RoboticsHardwareSolutions/BareMetal-PLCs-Vault/docs/baremetal-plc-m/doc/drawing/status-report.txt

Project Outputs Generation Report
---------------------------------
Start Output Generation At 17:46:57 On 29.01.2026

Output: Export STEP
Type  : ExportSTEP
From  : Variant [[No Variations]] of PCB Document [pcb.pcbdoc]
   Generated File[pcb.step]

Files Generated   : 1
Documents Printed : 0

Finished Output Generation At 17:47:27 On 29.01.2026
