RoboticsHardwareSolutions/BareMetal-PLCs-Vault/docs/baremetal-plc-m/doc/pcb/status-report.txt

Project Outputs Generation Report
---------------------------------
Start Output Generation At 17:47:40 On 29.01.2026

Output: Bill of Materials
Type  : BOM
From  : Variant [[No Variations]] of Project [bmplc.prjpcb]
   Generated File[Bill of Materials-bmplc.csv]

Files Generated   : 1
Documents Printed : 0

Finished Output Generation At 17:47:41 On 29.01.2026
