RoboticsHardwareSolutions/BareMetal-PLCs-Vault/docs/baremetal-plc-m/doc/photo/status-report.txt

Output: bot
Type  : PCB 3D Print
From  : Variant [[No Variations]] of PCB Document [pcb.pcbdoc]
   Generated File[bot.png]

Files Generated   : 1
Documents Printed : 0

Finished Output Generation At 17:46:51 On 29.01.2026
