RoboticsHardwareSolutions/BareMetal-PLCs-Vault/docs/baremetal-plc-m/doc/pcb/gerber/status-report.txt

Output: 4 layers NC Drill Files
Type  : NC Drill
From  : PCB Document [pcb.pcbdoc]
   Generated File[pcb-RoundHoles.TXT]
   Generated File[pcb-SlotHoles.TXT]
   Generated File[pcb.LDP]
   Generated File[pcb.DRR]

Files Generated   : 4
Documents Printed : 0

Finished Output Generation At 17:46:44 On 29.01.2026
