RoboticsHardwareSolutions/BareMetal-PLCs-Vault/BareMetal PLC M.md

![[BareMetal PLC L 2024-09-29 01.40.09.excalidraw|800]]
```table-of-contents
```

## BareMetal PLC M Description

### Overview

BareMetal PLC M Controller has various powerful features and can service a wide range of applications. The controller has the following interfaces on board:  CAN bus, RS485, RS422, RS232, 5 relay outputs, 5 discrete inputs, 5 discrete outputs, USB Device, EEPROM.  The main microcontroller is built on the Cortex-M3 core with a clock frequency of 72 MHz. 
### Hardware description

- Onboard [Rlink](https://github.com/RoboticsHardwareSolutions/rlink) programmer 
- MCU Cortex-M3: 72 MHz 
- RAM: 64 Kbytes 
- FLASH: 512 Kbytes 
- 256K  EEPROM
- 5 Relay outputs 55V  1.5A ( Max switch frequency 3Hz )
- 5 Discret Outputs (12-24V 70mA)
- 5 Discret Inputs  
- CAN Bus 
- RS485 
- RS232
- RS422
- USB Device

### Functional Diagram

![[BareMetal PLC L 2024-10-01 22.33.12.excalidraw|800]]
### Pinout and symbols 

![[BareMetal-PLC-M/doc/pinout/pinout.png]]

### Dimensions
![[Screenshot 2025-08-05 at 22.21.13.png]]

![[Screenshot 2025-08-05 at 22.21.29.png]]
![[Screenshot 2025-08-05 at 22.21.38.png]]

 3D model in .stp [here](https://github.com/RoboticsHardwareSolutions/BareMetal-PLC-L-assembly/blob/main/doc/assembly.stp)
