RoboticsHardwareSolutions/BareMetal-PLCs-Vault/attach/BareMetal PLC XL Product Brief 2024-09-28 23.10.22.excalidraw.md

---

excalidraw-plugin: parsed
tags: [excalidraw]

---
==⚠  Switch to EXCALIDRAW VIEW in the MORE OPTIONS menu of this document. ⚠== You can decompress Drawing data with the command palette: 'Decompress current Excalidraw file'. For more info check in plugin settings under 'Saving'

# Excalidraw Data

## Text Elements
## Embedded Files
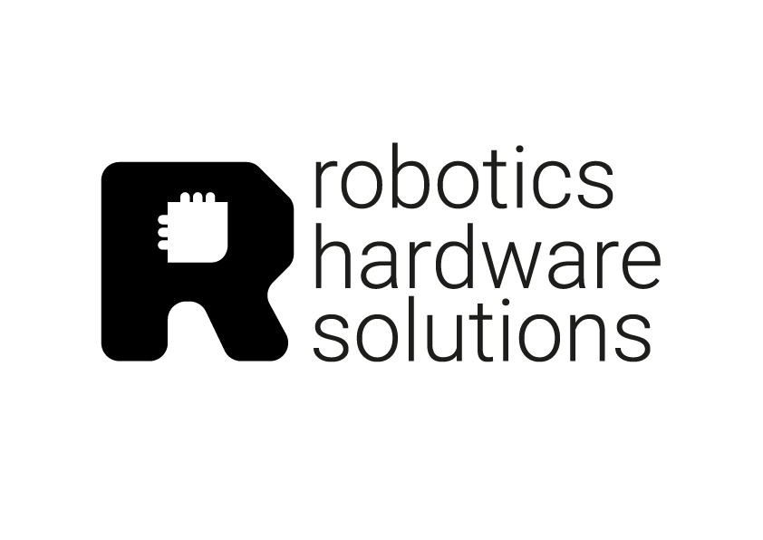
[picture p3: attach/Ресурс 1.png]
17b8354cb87843ab43a2fff041e272dd4be9363e: 

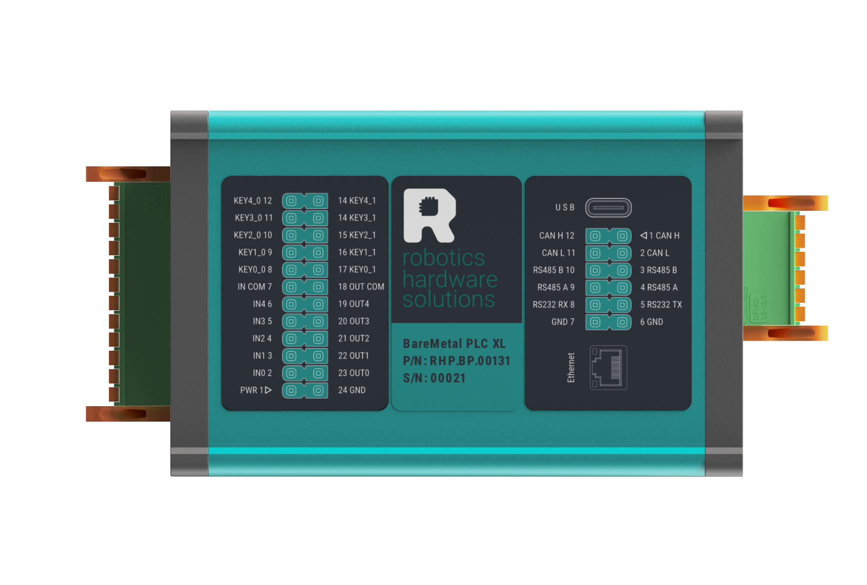
[picture p4: attach/roboticsALPHA.5b_site.png]
7c678ffba9f373350790c60da8705a2cec17a8e8: 

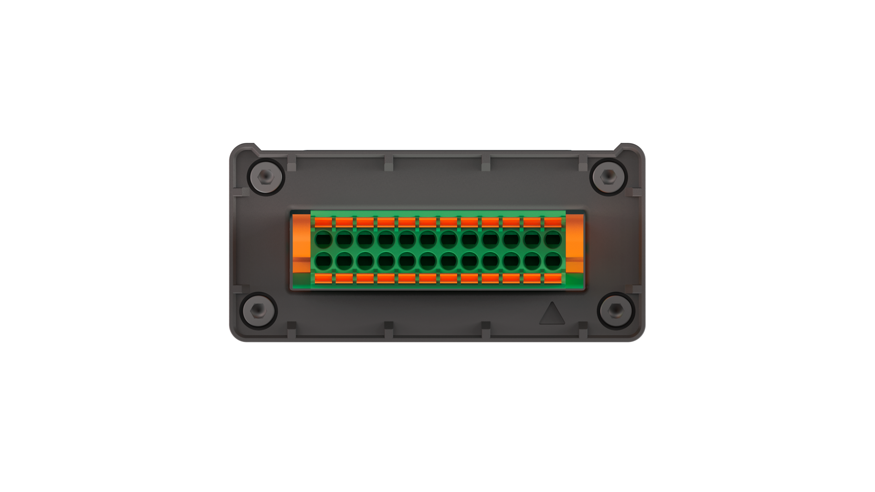
[picture p5: attach/roboticsALPHA.2a.png]
c31809eb0690865eb3441511a125cf84ea4b2b4b: 

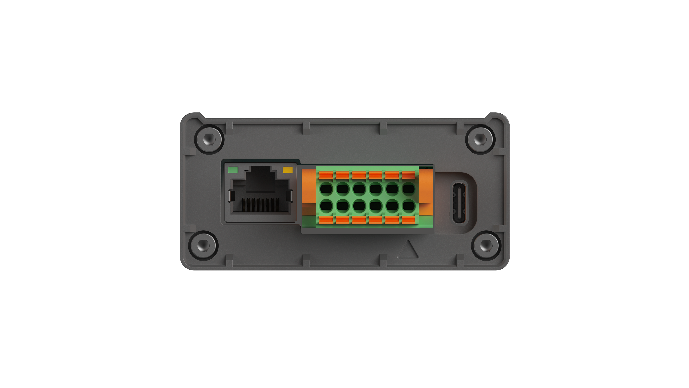
[picture p6: attach/roboticsALPHA.1a.png]
b8611a6e1363eb58c7db57ecf36b8be5c3dcc07f: 

%%
## Drawing
```compressed-json
N4KAkARALgngDgUwgLgAQQQDwMYEMA2AlgCYBOuA7hADTgQBuCpAzoQPYB2KqATLZMzYBXUtiRoIACyhQ4zZAHoFAc0JRJQgEYA6bGwC2CgF7N6hbEcK4OCtptbErHALRY8RMpWdx8Q1TdIEfARcZgRmBShcZQUebQAObQBmGjoghH0EDihmbgBtcDBQMBLoeHF0Qn1opH5SxhZ2LjQAFgB2AAY6yAbWTgA5TjFuAEYOgE4eePi2kZGk7ohCDmIs

bghcFMXCZgARdKgEYm4AMwIw7eOJfQB5ABkANgBlDk19VJLIE8J8fCfYYLrSS4bAaQIfUrMKCkNgAawQAHUSOpRosoTD4f8YICJIIPBDIDC/JIOOFcmgRos2HAQWoYKMOl1CpBrMocagmZ8IJhuM4kklEi14h0AKxJHjjJIdHhJFotB6LeloPnjFraB4jNqSyZJcbjB76tHQuEIADCbHwbFI62h1mYNMC2QJEE0INhyiJK3NlutEltHHtuEdUGdF

GRkm4IsZi0kCEIymk3CSYu04xGOr1HRa42mlOZEDCR0j8QF8UWHuEcAAksRyag8gBdRYnciZGvcDhCX6LT3EUnMOud7v5zTCFYAUWCmWydcbiyEcGIuEOV1Qmp4bRFW4eG+T40WRA4sI7XfwB7Y2Hhq7O+Au+ahy6EdYgiBWy2Uzu+wXbEk1mhLIotNg/5tPELRJLgmjgbgPAnHBWYjAgG48MQxAtJoCCSg8SS1Pe7gVAUnxgHmREjMyTb5tgMJw

CevyFAAvnUxSlCQ6wAJoAIodAA4gA0gAEgAskYzqwIg6xVDUzo8sqsoPNoIpjKBBoSvqIplvmSqoM48zyZqO48GKSRtBKcwKvmYbECirR6qmer2Q59ktDGcYJiGaD8m02g8Aa6kioZsoihqbSLKy7KcpCxrwt6Vo2uQAYOlkIaLK6l4VkIXoWrFfrxYGwafj8fwAhUUggmCuFcuiJpIlZEYUkaGIIFi7IFharE9sICb9nWJGlNStKwAyEWEmOfZk

rRZ73ggRZoAZ8S9T0TB9M0a6SosvRNIMHDDGgPBZkkGqqlq86LsuM1rpuco8CMYE8C06bbHsBznTed5cul1a1vkFFcqOGXEJOGRJbOP2lIex5oEOk1cpal4vecCDNj8CA/ugbTYA8oFwa64wnMZ/JRlqHQYx0S4zKKMFiNgmq4PECDxM6zD4fkzLEd0xHkdsKxrBIuAtBADFMfmrESPEmCwicGpPEIonlBJ1TKBVpQydpUqJFu/njEFe3CvK5lcl

pe1eWmGtSiMGotFmIqLJZ1moHK4wJAhcqgZbhr5rG8aJrtKbzOmmOSp0JsLPmYUVMNBZRWaWW+ug/p5Ulzqpe6vYxbH0C5YlTpI78zUlcCoIiErAhRzVdsLZHjV5+seLtfmRJdeN9X5v12B0kNHX/d1E1otNq5TJ0IX5htnBJiZ61LZtQwVCZUwPC0W4nUuK6jJdLTXZM2HTI9+zBCvaCvYj+YfTWIMpaNgPTjk30HssEOoFD55w9eCM5yjq4QNg

SQ3RMCCaB0BoOjxAeCKP+sp7qKRGLgEYhlsAnDAiEdCPAoKaEZszNAhFPgLQ5p8UGkBlirBVhsEUAsSiMUKMxfBH9YTcQAI4cRgD8ekiwxIlUkoraSvI1beRUpMGU/lFIaQNtwSU2gOjpnaLMeeup55CNKLbOq9s5QKV3OvGUcoJhBRcl7dyvAozaHNjKHUyZtY+VChwNk4cGomjTnFO0WdkojjdOlTKPo7EJSDInHORVsT5zKkXRmpdwyonvFHa

uuI2rHE7o3AcISuSt3bhSaM9dRrd0hqeXu50SzYRDlyEeK0Rhigno0AY08RHr3GFmKYFcFzL3OpqQC690w8BabKHez0X63iPu9Ikn0z4jgvlOYGN98zgx7qMi8V5Tiv3zF+d+6x/waigQ8BAukcKaHUtgNoxANltAQHAg6/4MIii/sQbA2AOhtBOGgggBFWbYLIrgrmhD1i4AeKQsA9FwA/Q2HAOA/wzrcGYtAWMmR1hEDchCBghAEAUAAELONTj

HdYABiOC6Lrl1E/iIYMVZDj6H+I1WxEgUWITJUrbFpBcX4oRWlJFbicr2M8dnQolLqUZAAGKFXCegWuUTWXYBxUlPFGRCXVWCbtLFgqqXCvxWKzExUa6RKhdK9l+gABKnUSRNzXFKoV2QRW3BpG3QaSSIpstlZyzgUAOW4H0EwyMeqZUGvxRy61TxCBGAqHtJ1aqAAqWAoAAEEIUrQgMEE4jjSiqstQSqIpBg1UrYBQWMuBVyPwFfqqAhrxwrCDU

mlNIQP5BhhFQX1sb82lr9XLCQvYoVMxhL8AAGiInM6opjTGMpjEy80sUNotPgNi3BwIjFTEFEyDxxHdpgViowbADBAuHgQIQFRR3XQePPcYgtM3OuzfizVXcdUQDrVij0JAPVeu4D61lZ7iD/AQDRNA1sb2kBIIJNgqxc2QWCJ0t6kBb3EtQJQiAcKLQf1IMoV0AAKa6IVeCamoPBuDHQFIAEpnTqoQMoLsQZ1gQegzKLovApSIcI4hlDIp0Pbuj

Vm+VCAbhwCgE0QcGTWUtjtQgTD3NX0WMXVyLI37zrQhXYsbARBH2oGE900oHAOPcCk1SIQUBDwVCk9RyAdgABW+ycgvFwHAd9n7ZOaB/dMrpWKQRMcYH6+d+A+OlFYTXdI2AmOj1E0+KABhq3iXScOGGkz4bmdGaEYNLnCDWdsxNBi4ByFfGRnWYAXz6JAA=
```
%%
