RoboticsHardwareSolutions/BareMetal-PLCs-Vault/attach/BareMetal PLC L 2024-09-29 01.40.09.excalidraw.md

---

excalidraw-plugin: parsed
tags: [excalidraw]

---
==⚠  Switch to EXCALIDRAW VIEW in the MORE OPTIONS menu of this document. ⚠== You can decompress Drawing data with the command palette: 'Decompress current Excalidraw file'. For more info check in plugin settings under 'Saving'

# Excalidraw Data
## Text Elements
## Embedded Files
17b8354cb87843ab43a2fff041e272dd4be9363e: 

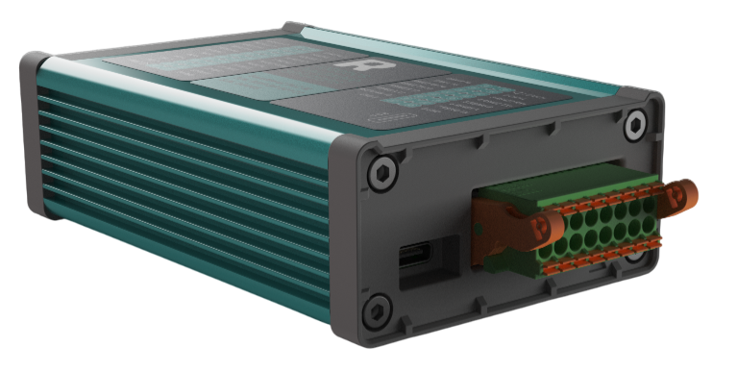
[picture p7: attach/Untitled3.png]
45a09c3cb31096cdb58ccd8873f9a5ce9564a077: 

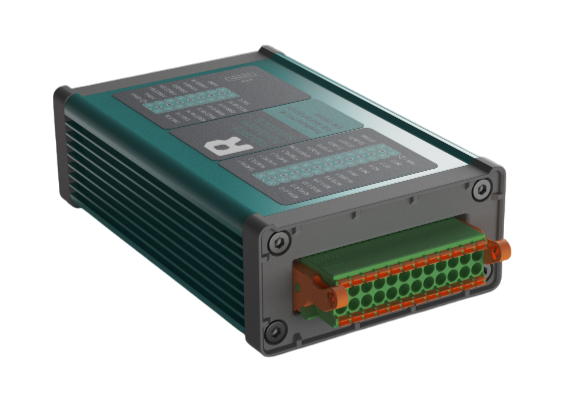
[picture p8: attach/Untitled.png]
ec1cabf1424fadb6adf64a130d58d2e07b59a7e2: 

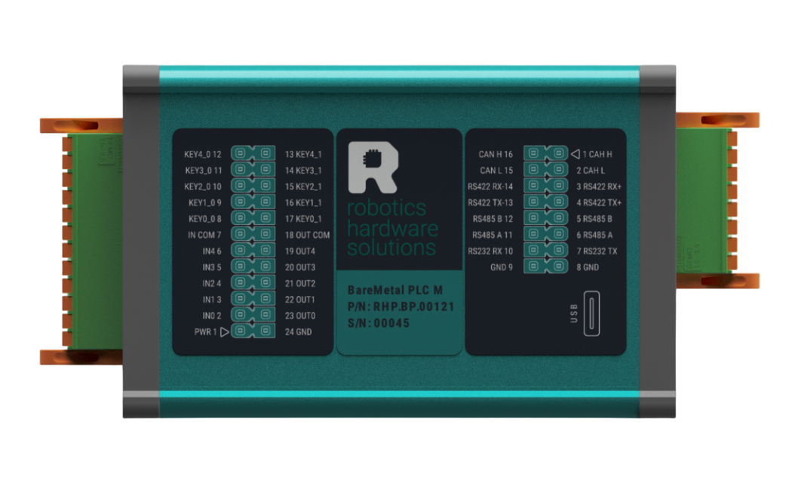
[picture p9: attach/Untitled 2.png]
acdc02df39efdd17fbaf7d9cfea49035cd332f42: 

%%
## Drawing
```compressed-json
N4KAkARALgngDgUwgLgAQQQDwMYEMA2AlgCYBOuA7hADTgQBuCpAzoQPYB2KqATLZMzYBXUtiRoIACyhQ4zZAHoFAc0JRJQgEYA6bGwC2CgF7N6hbEcK4OCtptbErHALRY8RMpWdx8Q1TdIEfARcZgRmBShcZQUebQBWbQBGGjoghH0EDihmbgBtcDBQMBLoeHF0Qn1opH5SxhZ2LjQAdgAWAGY6yAbWTgA5TjFuHiSkgA4W+KT4tpbuiEIOYixu

CFwO1JLIQmYAEXSoBGJuADMCMIWSNf0ASQBpbABZABU4ACsAGWIAKQAlNowABqbCMAC0AIJtfpbUqnQj4fAAZVgwTWklw2A0gVhAigpDYAGsEAB1EjqbhJBbMfFEhAomBoiSCDy4iAEvySDjhXJoKmFSBsOCYtQwSkABnFC2syiZqClAogmG4ziS4sS8Q6ADYAJxJLUdeLjHhtHjGhZitDOA1JbSGrUtPXjLU8DpjNrU2nEgDCbHwbFIa3x1mYws

C2TZmkxhOUHOWvv9gYkwY4odw4agbIo5Mk3HiLS12i1+fzOo6krmboWkgQhGU0m4bXF42S43Fps64p4Orm80VYWOlJ4PBd0zaxYWseEcFuxF5qDyAF0FqdyJlZ9wOEJEQs48Rucx51ud4rNMJlgBRYKZbLzpcLIRwYi4I4nPktQ3ix08L+THULIgOEJTdt3wAC2GwYk31Qc58EufsoigIR5wgRBliWZQ2XhYINwkJIWk0cZDTabBCJacZOlwTRKJ

4U46PbJIEB4FoeGIYg2k0BAywNWp+3cCoCm2MB+SEpIBUXQoAF86mKUpYEQNYqhqNleiaPN4niBZVIGIYKh4DSiLbTormWVYJFweI2V2A5glfM4LgQK5oIgT4jCBAAJAAhbAOgAcSwhFkVRCopExbFeO2CAaQJYkyWICk+U9GL6WCtYWWuXdhHrA95xE0ohRFWAJQVSKZTlErSmVK1OhaIt4h1eJR3q8sdT7SLLVQDouqLNo9XFd19I/NrSmiukE

wDINyFTMMskzBYo0gqchHjP0JuTKa0wzLMc24VrC1dHViyScdWsarpFRrOsGzQXrbXLCYOhNUZZi1PKBAQQc0DbdotUnDkZznfJl0VVdcHXaDjzAxU9xykCT0is9luIK8Mlmu9gcix9nzs99P3I/CmySf9FUA4C0Eh8DIM+mCHM9F9kLWNDHA4TCVwRBBcPQNp4lwcUdR80i3T5rVsGITQjWwUXxkmDpTh1CyxAarU2l5loWjZZh+PyAVhO6YTxK

kmTFXkkKlOUCL6iYPpmlQNU+EVbSOEGDhhhu4cvzGfMTJWKr0AsoErP2Q5qdg+DIuuZMIRJeIEF8mAAEcAsRBk5VCrERAtvFkrihLbaSukU5C9KTkyzlYcSxUCuwUViulFnyoWX3nG5jptB1cYxhmYd9I7zTFQ65wOjaW0yzaDuZg0gs1fzn1VqTdAU022bI2jJaVsTSaQxmiMFmzeLcz5d1tHGeqx5afrlZLata3rTM0C1cYdTqljlfFV6h6H6k

Puglo1QdP7pyznRiuNcHMIagVLsscuqAKannPMja8aMgYPifC+am+E8YdxYvqX6JMlhkxgRAkmEEoL2Tgo5BC9MUJMwwknMBaxMTEGwF2YgpwOg6gQKcNi+FThRlOC0Yg/NTghF6uKQ0osuq0VNBrLWaBBLbDevrbYEkSjSUKLJSAJtFLVHNipK2ak0BdQ9A7fROkXYVA6G2UYD8+7h1Mr7dYWpA42QQDjGm5CnJrHGO8LUSJSCnFuDCNmydUoSA

xOnHEM9SQ7QrpFUaxJC5pT9BlaGWUuQ8kpAsKuNc+SSjrrKCoFVIC+zmEWNW59DTDi1Axc67UVRjG0D+cpmpjT1WLD2KJ4157QA2tvOap5V57i6Zvaa6Zl67xiagMsiRuxug6ORB0xY37XyunfVABpxRt2VtqAyXYmlf2pg1Pmb0IBLQBsAkGoDOawMijDDJ5MiEI3gSjG8ORkGKixmg6CGD4i/jftMopEBSZwyhpFf0VNoKhwoXExCDMJA0JZnQ

zmGBsBJDwJoU4x0TTnDFlqXArDla4CSOWYgRpiA8AQF+cW8sWhMRkQQASOtVR6zEsoqS4AMbrDgHAFEaDuCyWgDWTIawiC31hAwQgCAKCeUGfA4ZEgADEdFlWnHFdgEQGZbhHH0CiZK8r0AKsYkai2EB1WkE1dqmVi0hlzxGUvHehRTUatmlqjIAAxQKiTmTJJLo6s1FqMi6rpDnA+vA6hOvNS67VQaEmhPQMXNVzrsiuv0H8NJ0C8oRoDfoAA8s

KauRVckVSzVG91nAoBurBgiDqtjID+tLfoN15akSECMHpYt9bk3apeFgKAEJRU2yBZw/ppRO1QBTby0gfbzVsAoDWfFILw1jpTReZYEIZ1zpCM5dMBIqBLqTeO7V67d0vHKGsPc4rNYEkRAADW4FMFsrUfzlhPkZZZjqr1+nwAATW4FqB02hHTti6qddU+Fw1GDYAYflDsCBCEKQkW6x1DZ+oPSmtNSNoHsngeK2MJAW1tpGMWvDxAUQIDgHmcNJ

GnhsBWKuqiwRIW00dSR/VGiICeT9M5UgygowAApRjzF4OB4TQnNnxAAJRsj+AgZQ250znt47gAT5ZqC8FU+pqU8oEhSZQ6Og9MaEB5qgE0I8jzICg0yDJ0ypBaFoHY1kBj1N8TwYWNgIgFG0AuehaUDgYMKjeayUIKAgEAukHg3pwUmh3gIGwDkJEfm4A0bo35zQjGyFh0gJiEzjAXhQfwDByKWjmTpDi2pNzyEoAGFPQpB58NSjgtIWgKFAFQh9

rK7l/LIL2VgDURZ9m85gCSRAJJIAA===
```
%%
