RoboticsHardwareSolutions/BareMetal-PLCs-Vault/docs/attach/baremetal-plc-l-small.26.png

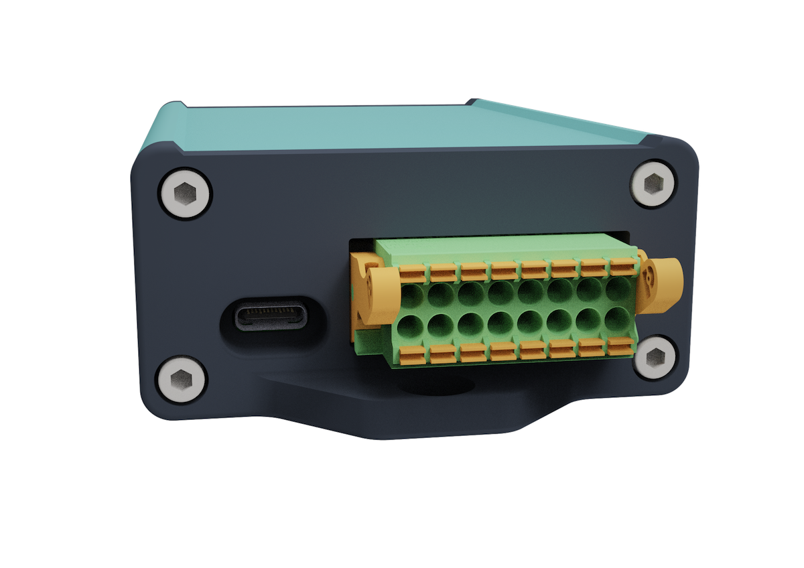
docs/attach/baremetal-plc-l-small.26.png
