RoboticsHardwareSolutions/BareMetal-PLCs-Vault/docs/attach/baremetal-plc-l-small.29.png

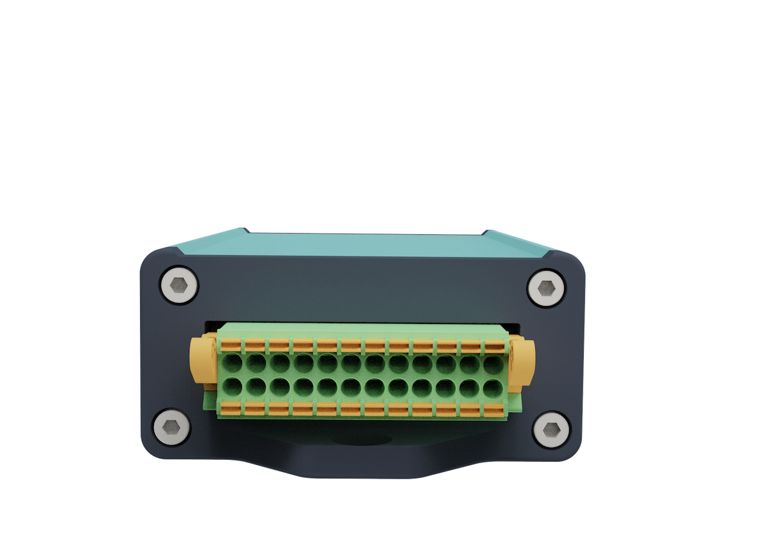
docs/attach/baremetal-plc-l-small.29.png
