RoboticsHardwareSolutions/BareMetal-PLCs-Vault/docs/attach/baremetal-plc-xl-1-small.22.png

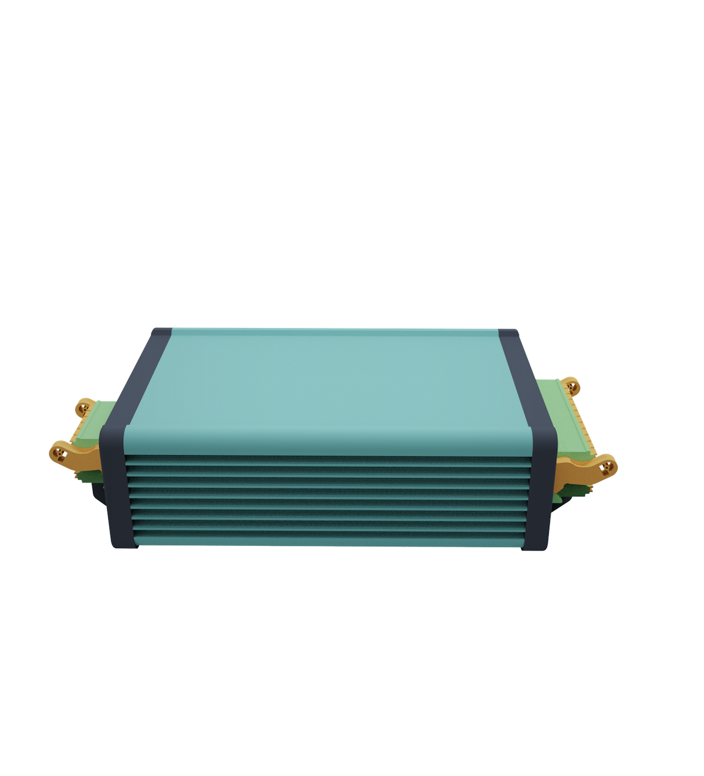
docs/attach/baremetal-plc-xl-1-small.22.png
