RoboticsHardwareSolutions/BareMetal-PLCs-Vault/docs/attach/baremetal-plc-xl-1-small.23.png

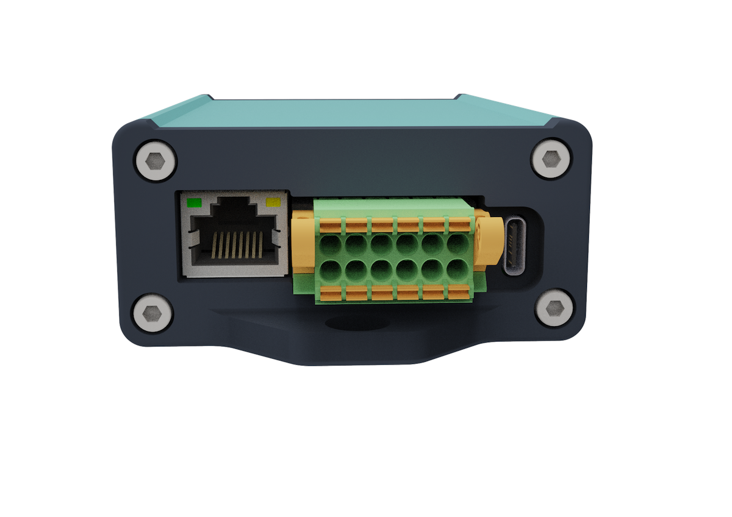
docs/attach/baremetal-plc-xl-1-small.23.png
