RoboticsHardwareSolutions/BareMetal-PLCs-Vault/docs/attach/baremetal-plc-xl-1-small.24.png

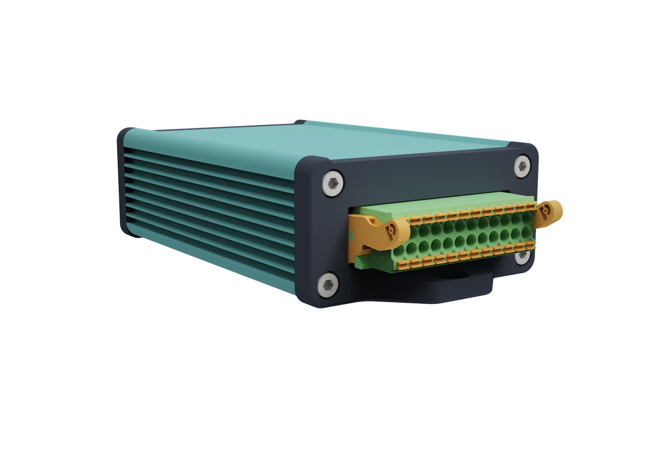
docs/attach/baremetal-plc-xl-1-small.24.png
