RoboticsHardwareSolutions/BareMetal-PLCs-Vault/docs/attach/robotics.6s-photoroom.png

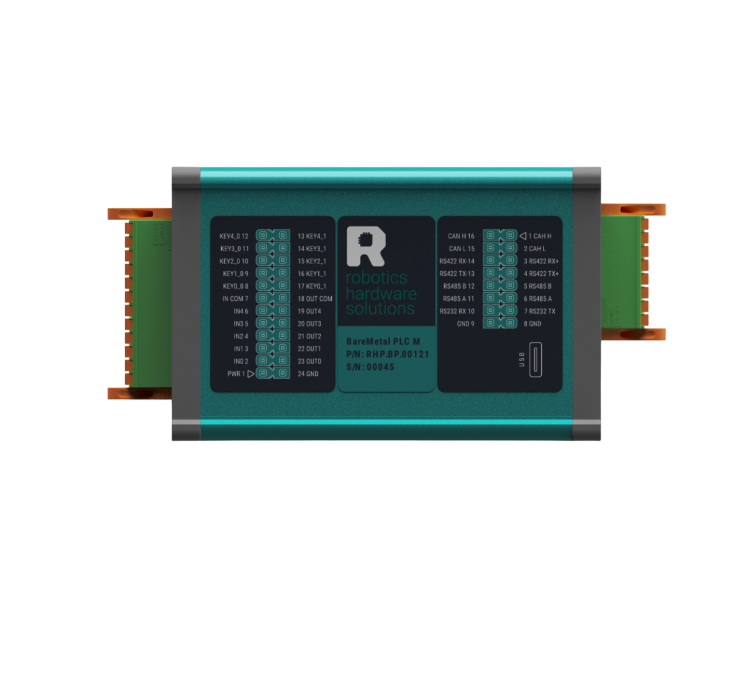
docs/attach/robotics.6s-photoroom.png
