RoboticsHardwareSolutions/BareMetal-PLCs-Vault/docs/attach/robotics.6s.png

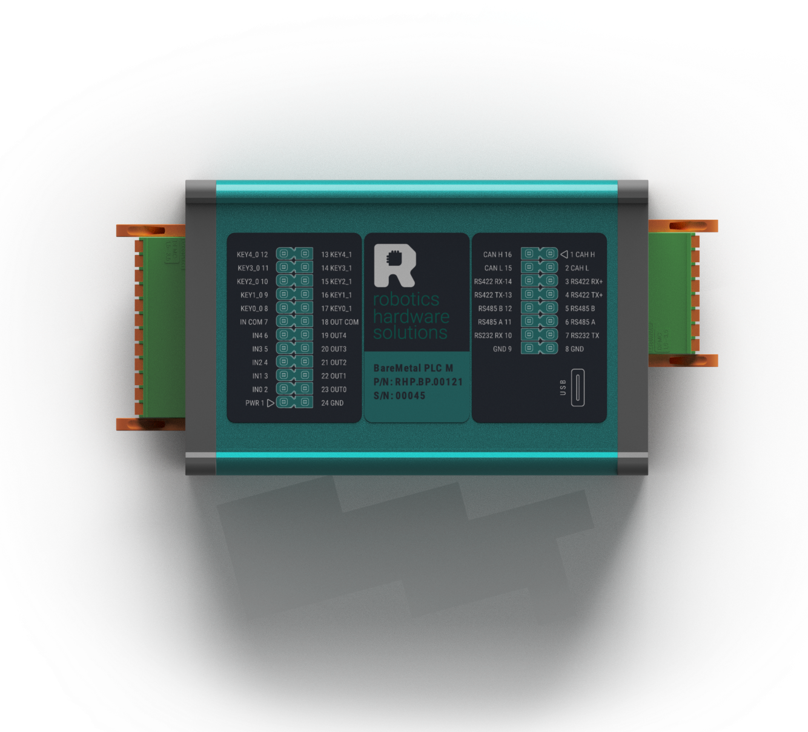
docs/attach/robotics.6s.png
