RoboticsHardwareSolutions/BareMetal-PLCs-Vault/docs/attach/robotics.8а.png

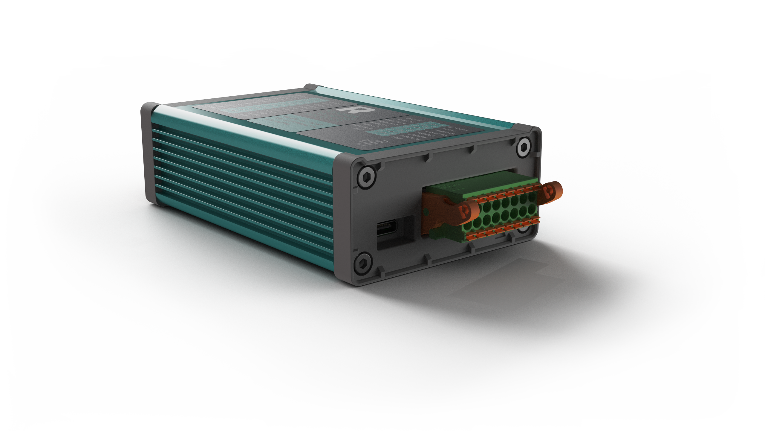
docs/attach/robotics.8а.png
