RoboticsHardwareSolutions/BareMetal-PLCs-Vault/docs/attach/robotics.26а-photoroom.png

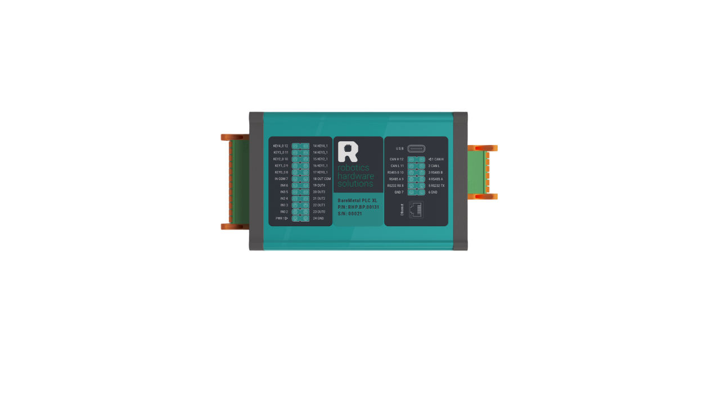
docs/attach/robotics.26а-photoroom.png
