RoboticsHardwareSolutions/BareMetal-PLCs-Vault/docs/attach/roboticsalpha.1a-site.png

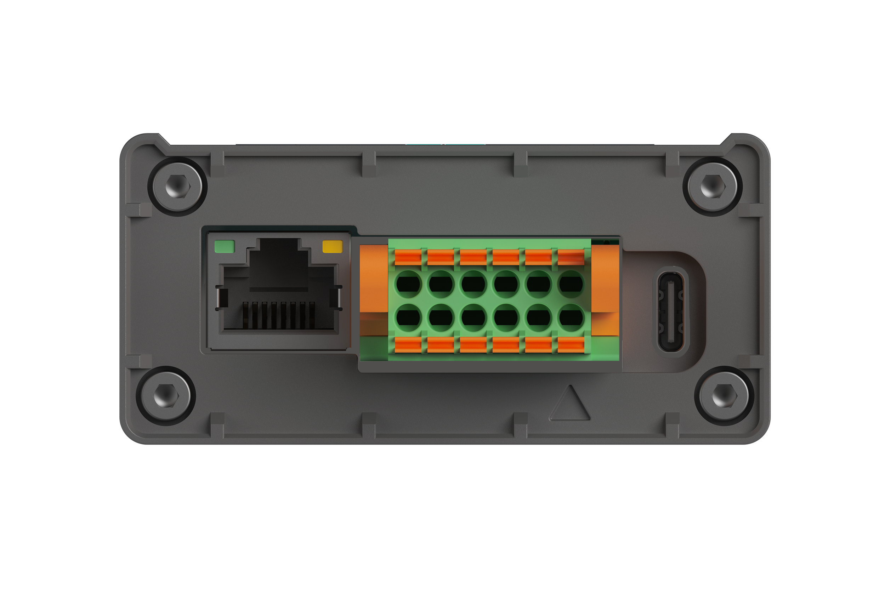
docs/attach/roboticsalpha.1a-site.png
