RoboticsHardwareSolutions/BareMetal-PLCs-Vault/docs/attach/roboticsalpha.6а.png

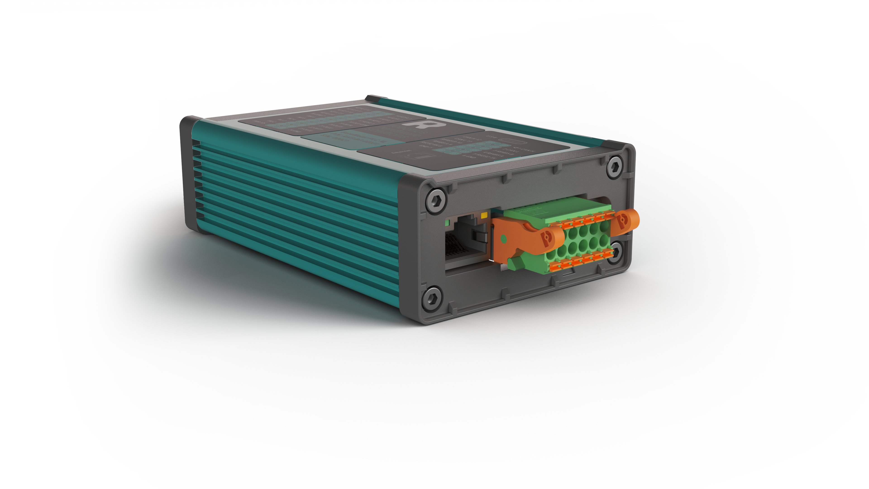
docs/attach/roboticsalpha.6а.png
