RoboticsHardwareSolutions/BareMetal-PLCs-Vault/docs/attach/screenshot-2025-04-17-at-21.55.15.png

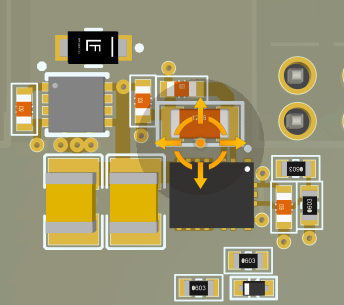
docs/attach/screenshot-2025-04-17-at-21.55.15.png
