RoboticsHardwareSolutions/BareMetal-PLCs-Vault/docs/baremetal-plc-l/doc/pinout/pinout.png

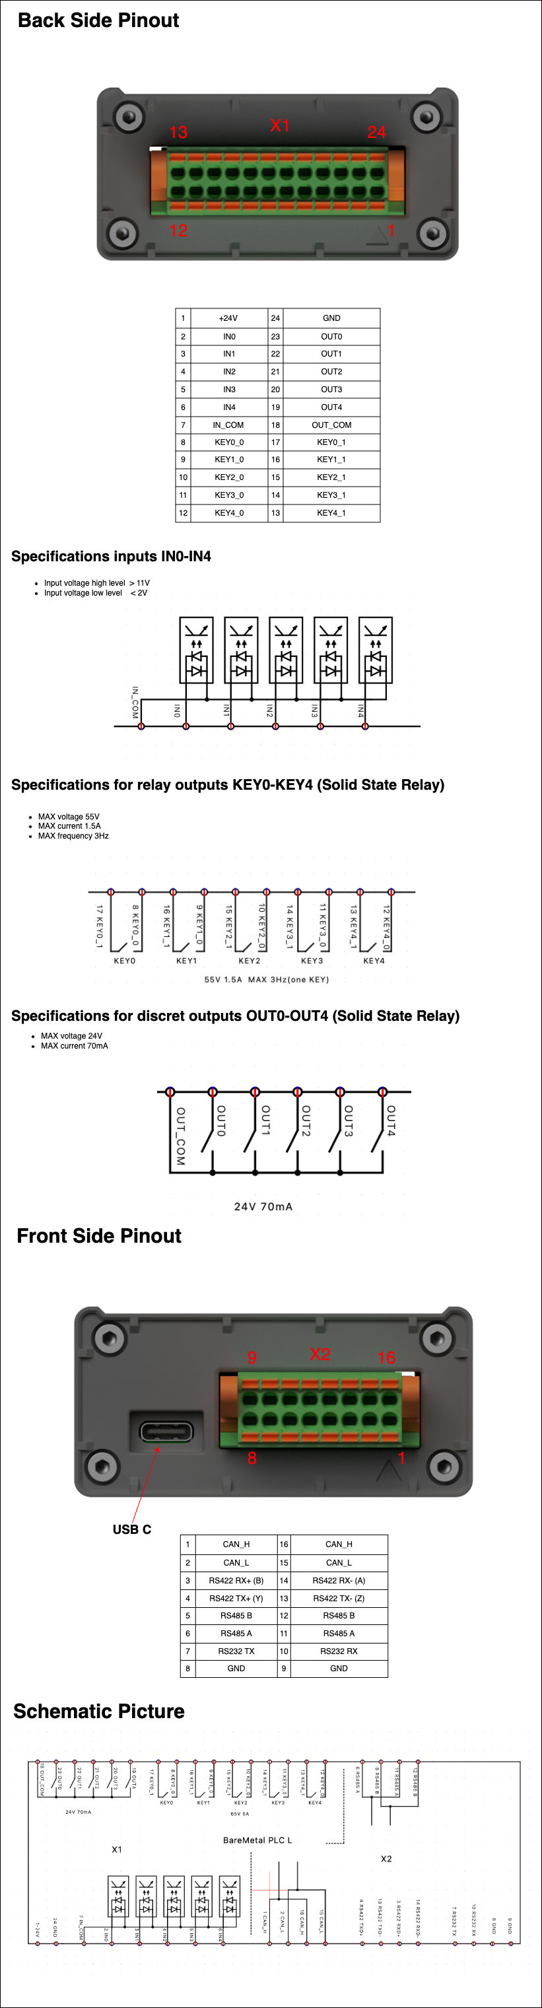
docs/baremetal-plc-l/doc/pinout/pinout.png
