RoboticsHardwareSolutions/BareMetal-PLCs-Vault/docs/baremetal-plc-m/doc/pcb/board_options_draw.png

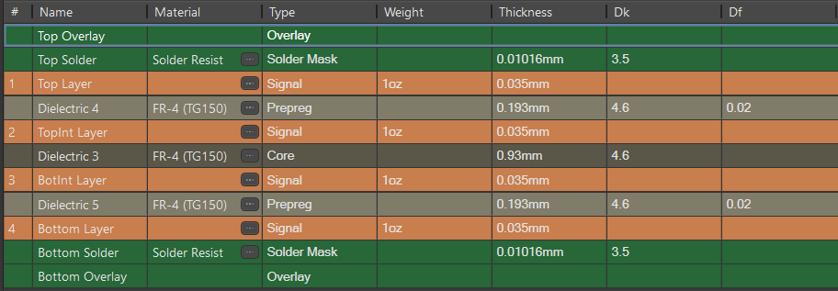
docs/baremetal-plc-m/doc/pcb/board_options_draw.png
