RoboticsHardwareSolutions/BareMetal-PLCs-Vault/docs/baremetal-plc-m/doc/photo/bot.png

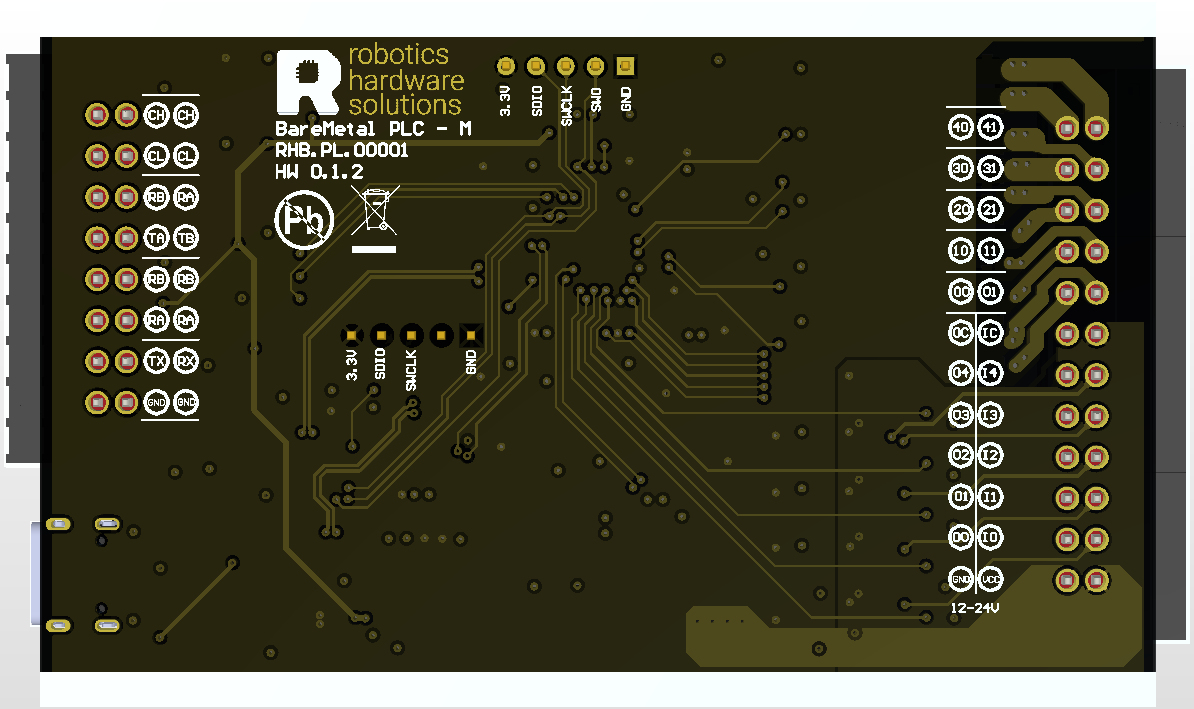
docs/baremetal-plc-m/doc/photo/bot.png
