RoboticsHardwareSolutions/BareMetal-PLCs-Vault/docs/baremetal-plc-m/doc/photo/top.png

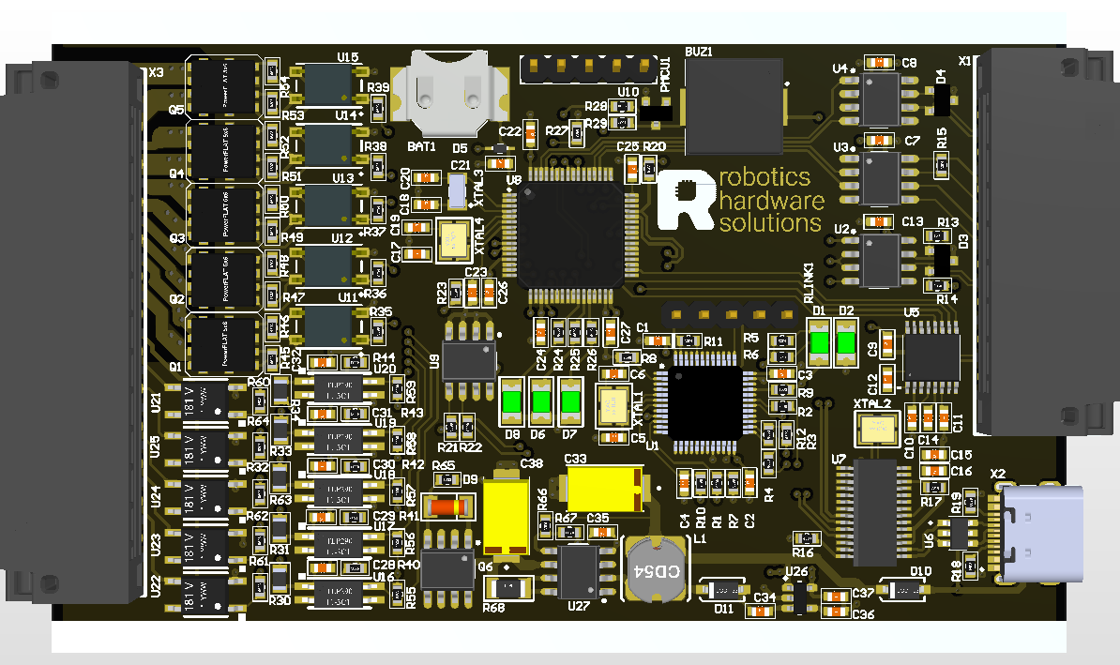
docs/baremetal-plc-m/doc/photo/top.png
