RoboticsHardwareSolutions/BareMetal-PLCs-Vault/docs/baremetal-plc-xl/doc/photo/bot.png

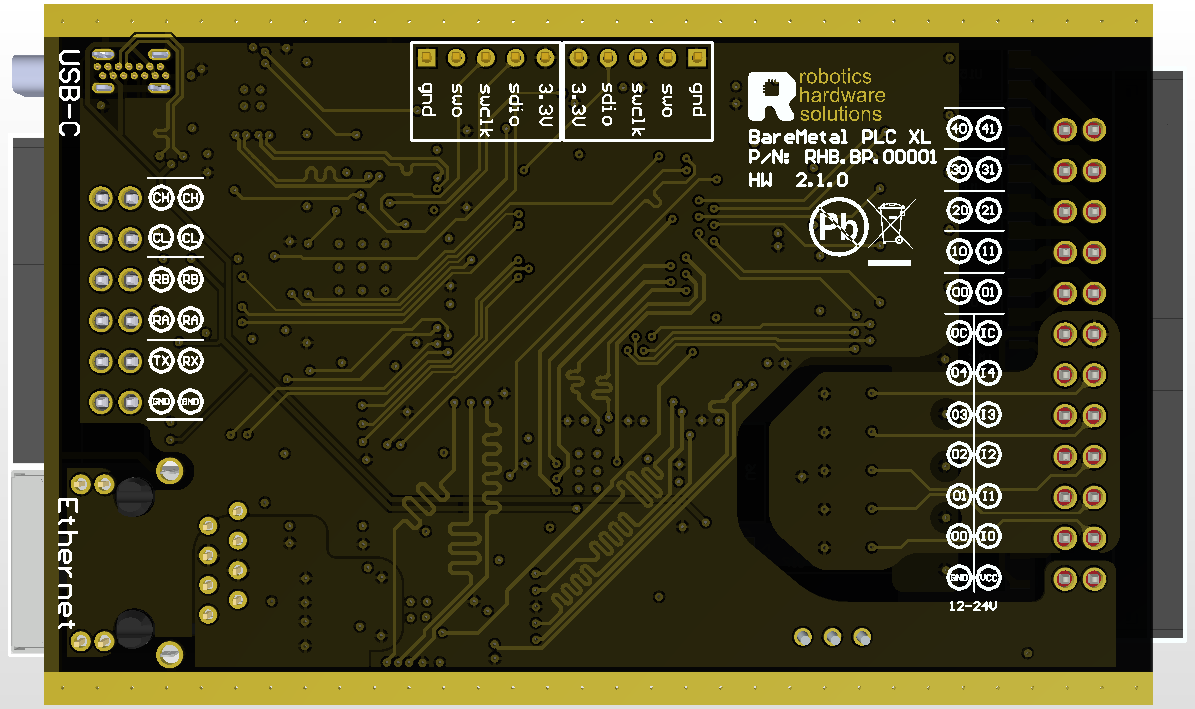
docs/baremetal-plc-xl/doc/photo/bot.png
