RoboticsHardwareSolutions/BareMetal-PLCs-Vault/docs/baremetal-plc-xl/doc/photo/top.png

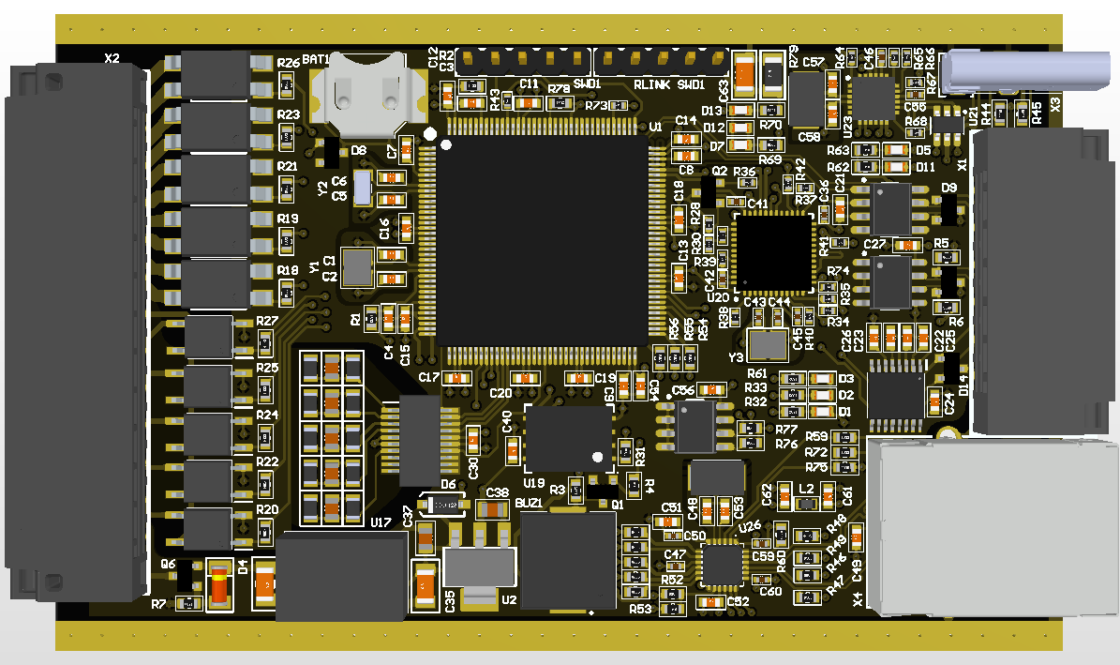
docs/baremetal-plc-xl/doc/photo/top.png
