RoboticsHardwareSolutions/BareMetal-PLCs-Vault/docs/docs/attach/screenshot-2025-08-04-at-22.24.19.png

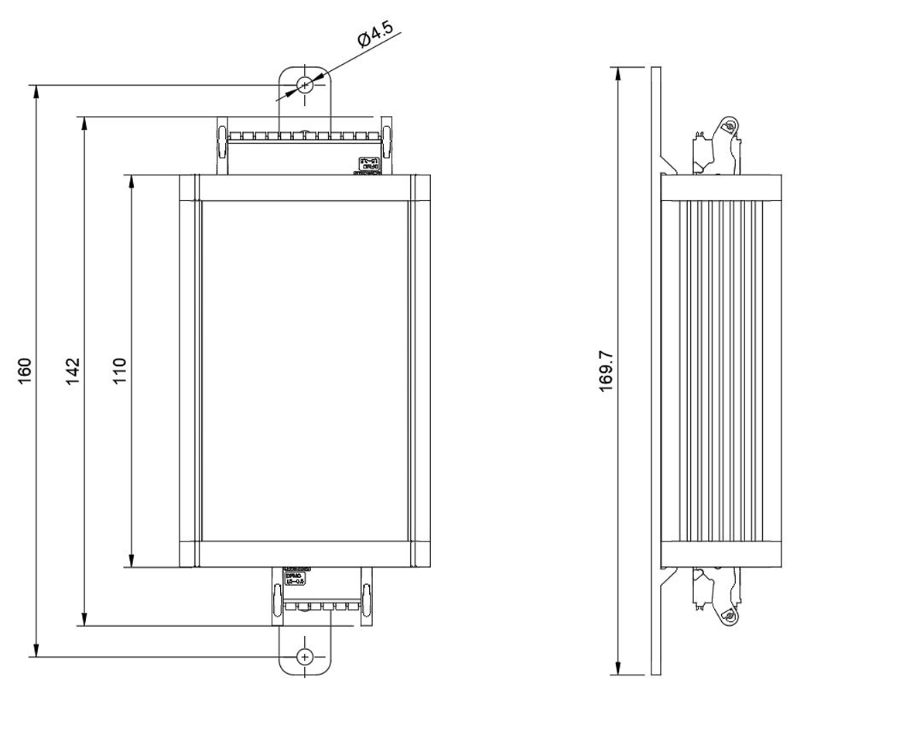
docs/docs/attach/screenshot-2025-08-04-at-22.24.19.png
