RoboticsHardwareSolutions/BareMetal-PLCs-Vault/docs/docs/attach/screenshot-2025-08-05-at-22.21.38.png

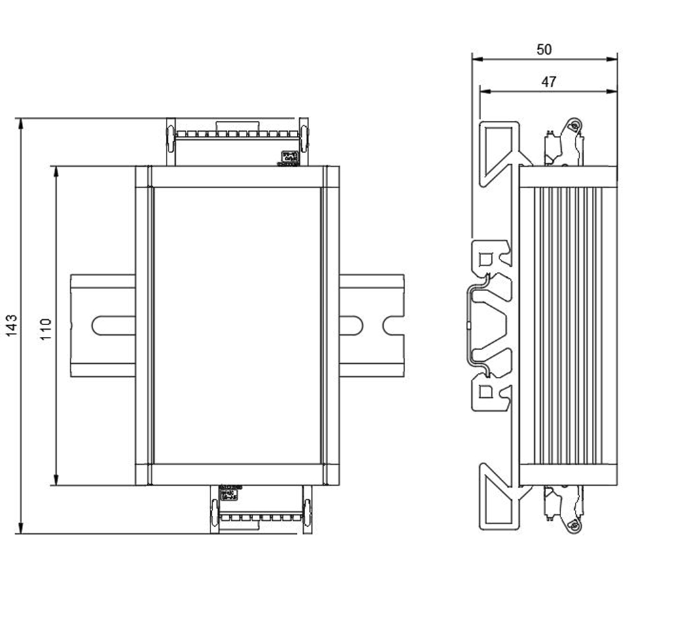
docs/docs/attach/screenshot-2025-08-05-at-22.21.38.png
