RoboticsHardwareSolutions/BareMetal-PLCs-Vault/docs/docs/baremetal-plc-m/doc/pinout/pinout.png

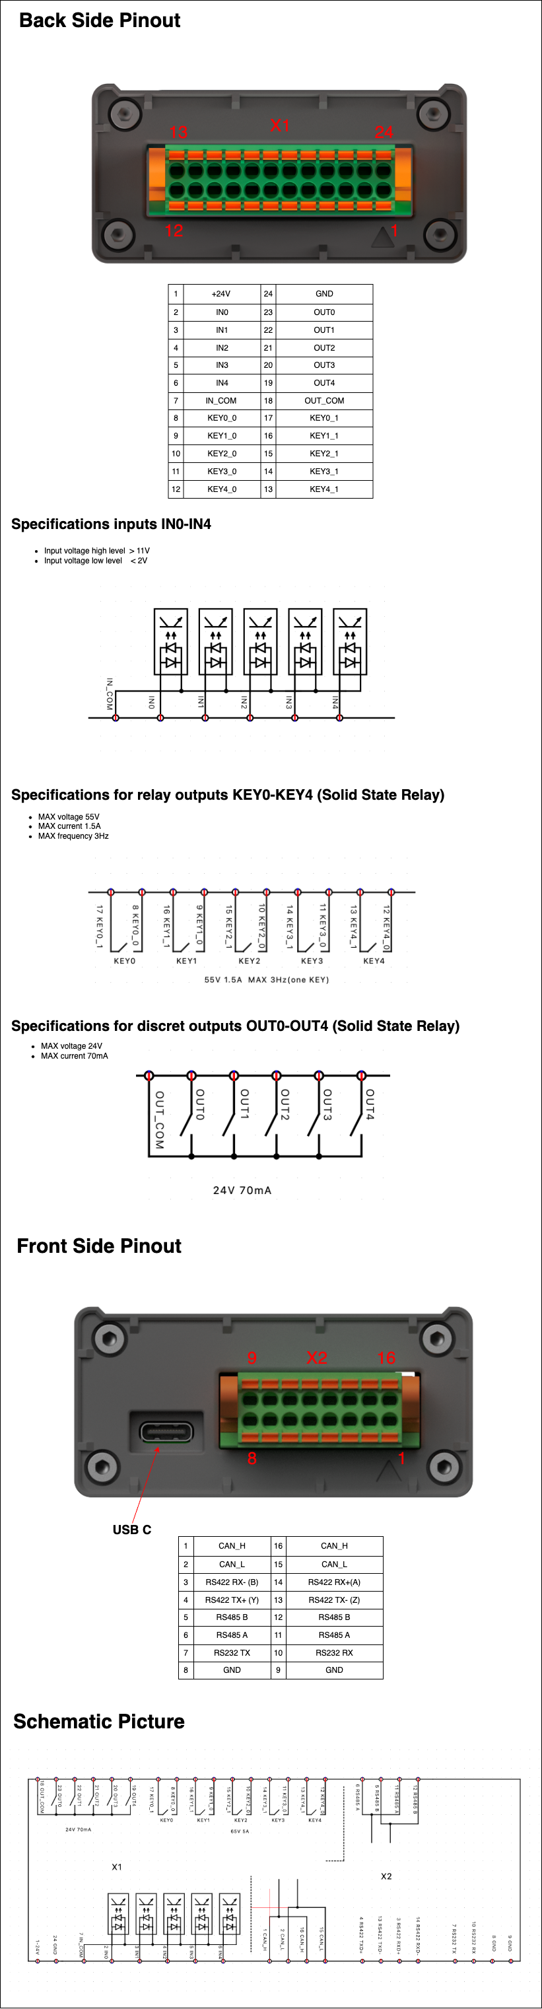
docs/docs/baremetal-plc-m/doc/pinout/pinout.png
