RoboticsHardwareSolutions/BareMetal-PLCs-Vault/docs/docs/baremetal-plc-xl/doc/pinout/pinout.png

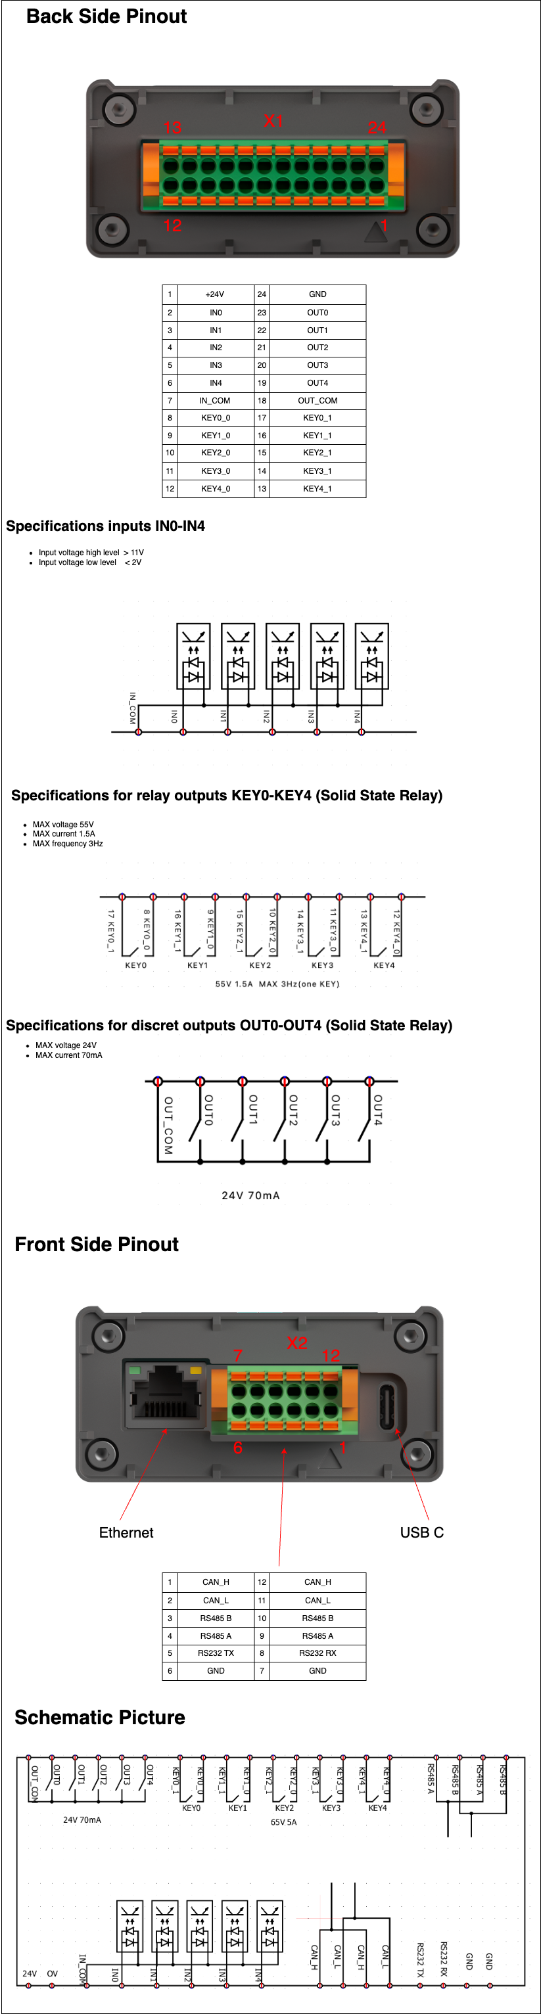
docs/docs/baremetal-plc-xl/doc/pinout/pinout.png
