RoboticsHardwareSolutions/BareMetal-PLCs-Vault/docs/baremetal-plc-m-assembly/step/surface-mounting.step

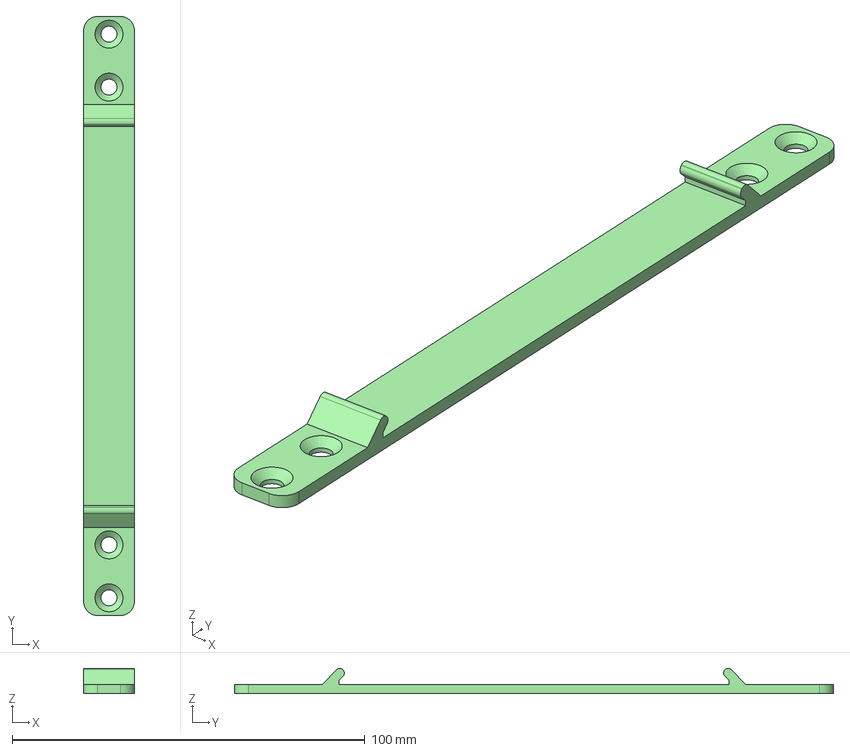
[picture p37: CAD file, 2026-08-28]
docs/baremetal-plc-m-assembly/step/surface-mounting.step
14.4 x 169.7 x 7.18 mm
