RoboticsHardwareSolutions/BareMetal-PLCs-Vault/docs/baremetal-plc-m-assembly/step/case-a.step

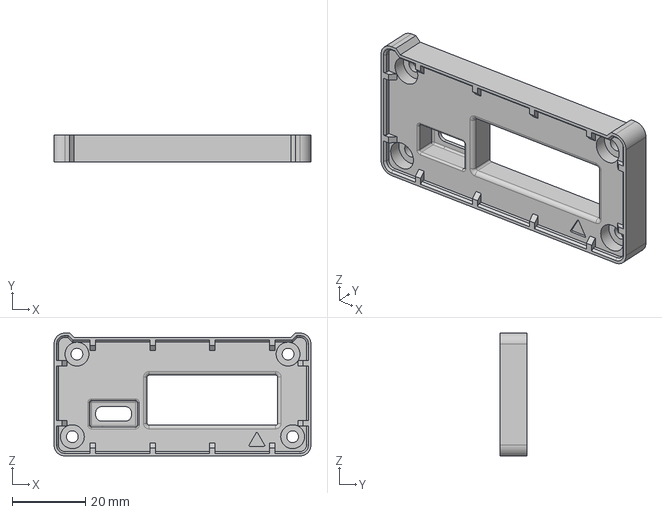
[picture p38: CAD file, 2026-08-28]
docs/baremetal-plc-m-assembly/step/case-a.step
70.0 x 7.30 x 33.5 mm
