RoboticsHardwareSolutions/BareMetal-PLCs-Vault/docs/baremetal-plc-m-assembly/step/din-rail-mounting.step

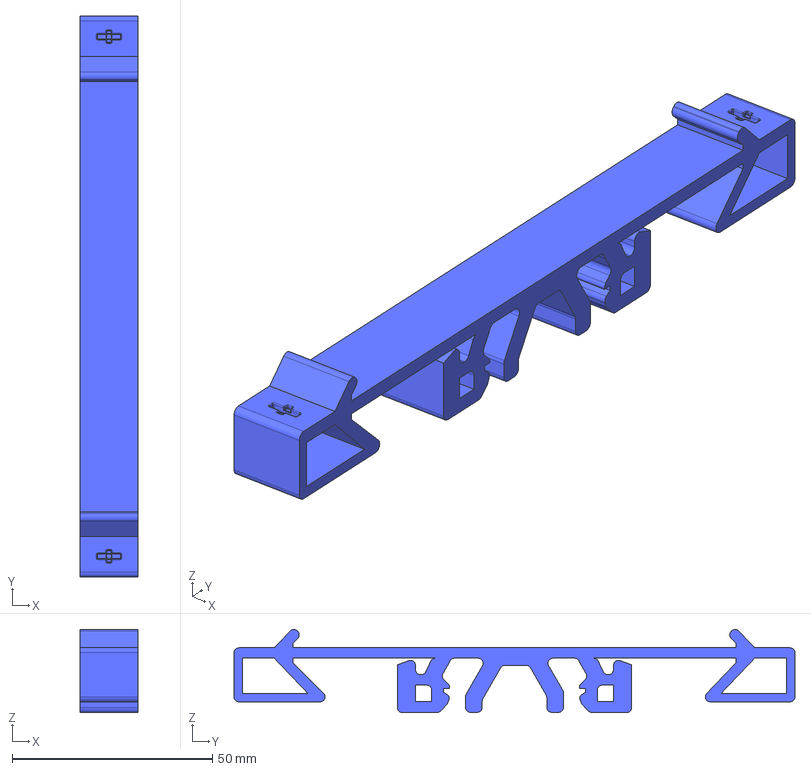
[picture p39: CAD file, 2026-08-28]
docs/baremetal-plc-m-assembly/step/din-rail-mounting.step
14.4 x 140.0 x 20.7 mm
