RoboticsHardwareSolutions/BareMetal-PLCs-Vault/docs/baremetal-plc-m-assembly/step/case-b.step.step

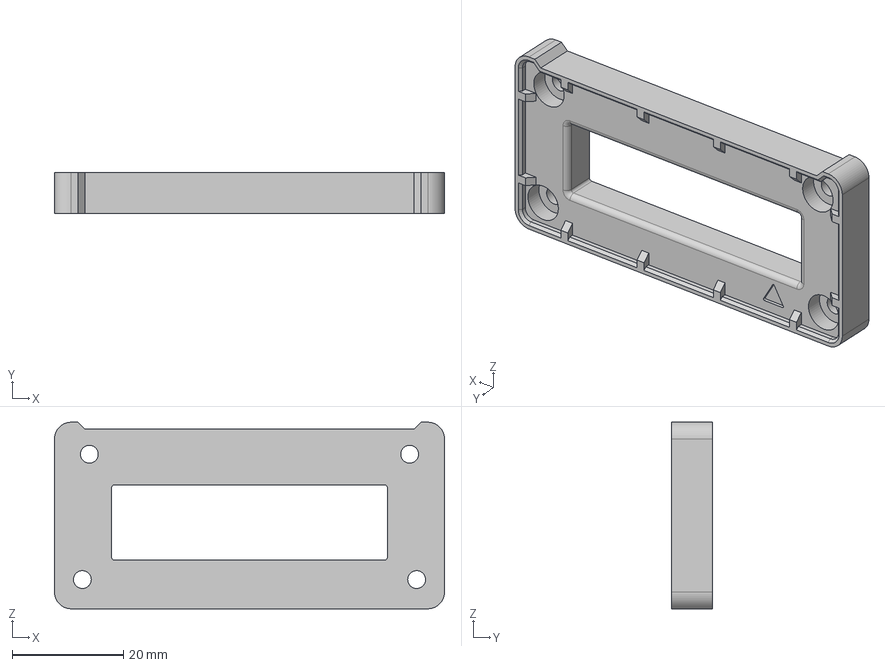
[picture p40: CAD file, 2026-08-28]
docs/baremetal-plc-m-assembly/step/case-b.step.step
70.0 x 7.30 x 33.5 mm
