RoboticsHardwareSolutions/BareMetal-PLCs-Vault/docs/baremetal-plc-m-assembly/doc/drawing_m.pdf

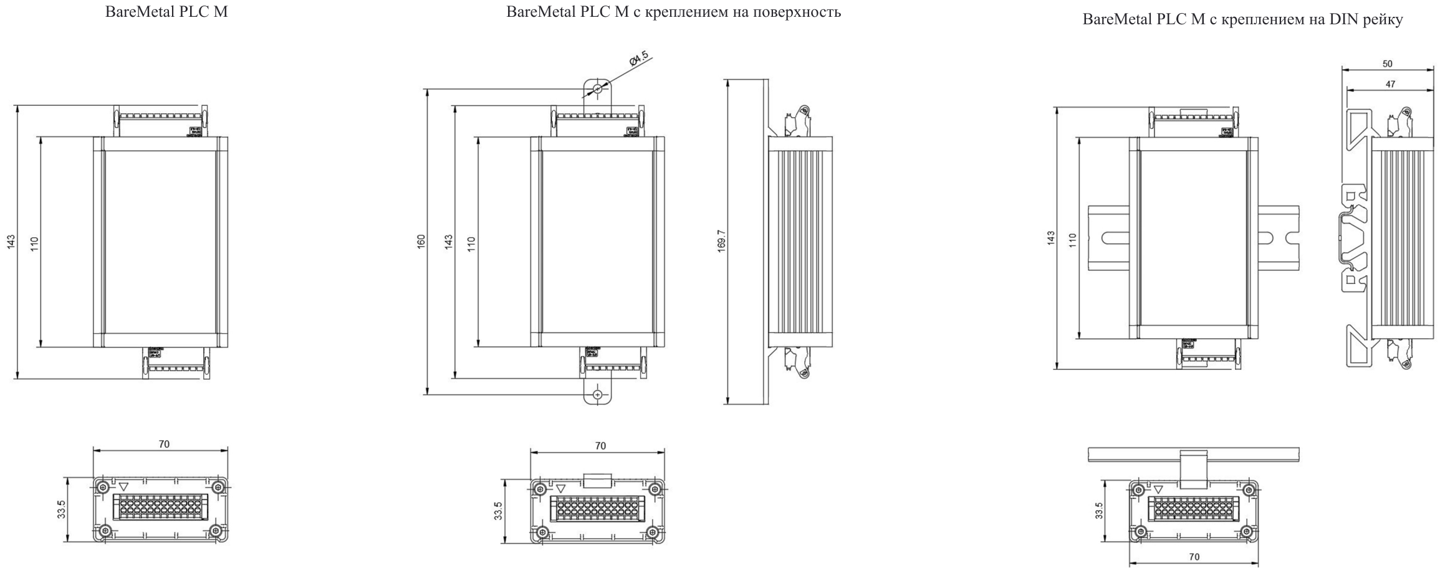
[picture p41: page 1]

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
