RoboticsHardwareSolutions/BareMetal-PLCs-Vault/docs/baremetal-plc-xl-assembly/doc/чертежи.pdf

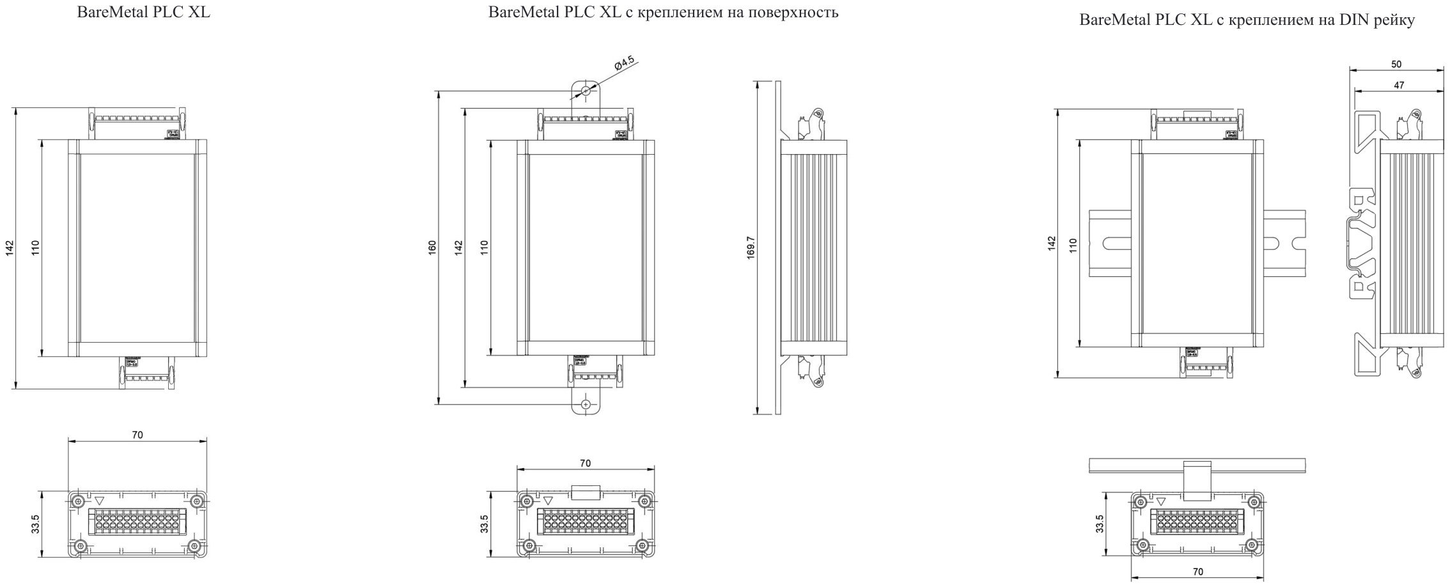
[picture p42: page 1]

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
