RoboticsHardwareSolutions/BareMetal-PLCs-Vault/docs/baremetal-plc-xl-assembly/doc/чертежи.png

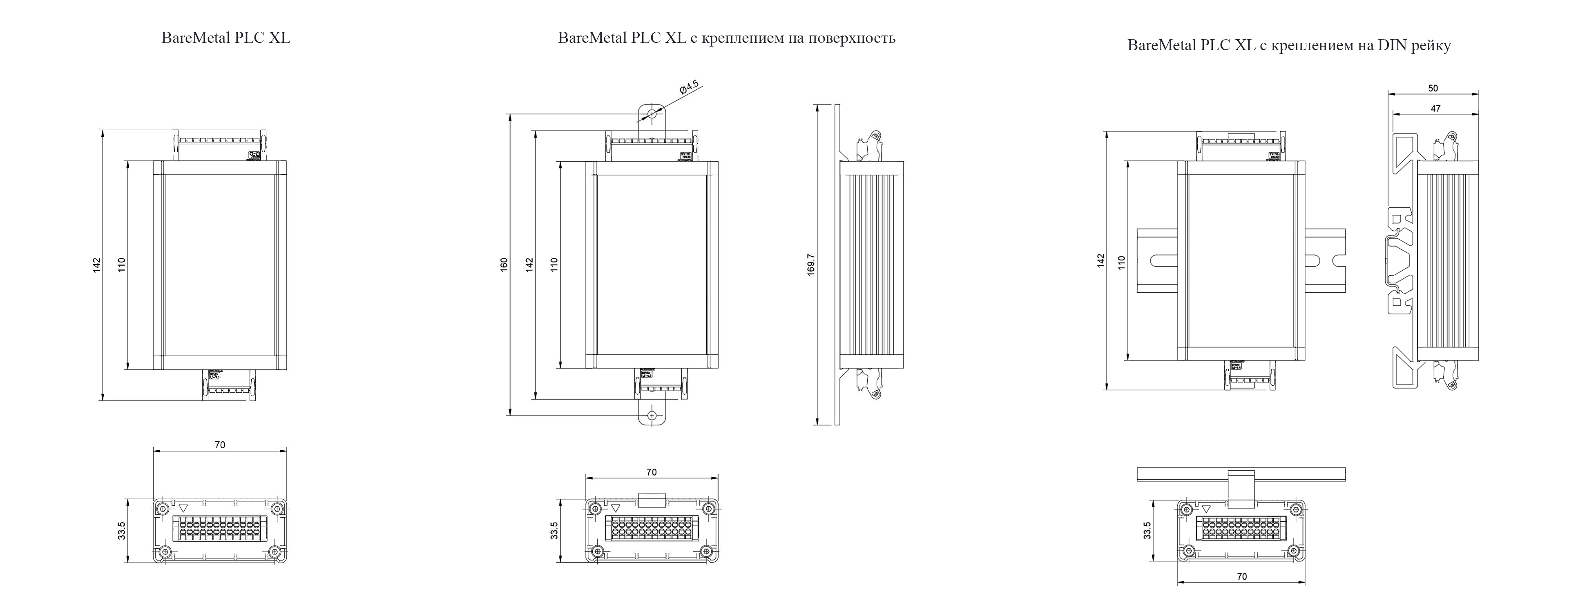
docs/baremetal-plc-xl-assembly/doc/чертежи.png
