RoboticsHardwareSolutions/BareMetal-PLCs-Vault/docs/baremetal-plc-m/doc/pcb/assembly-drawings.pdf

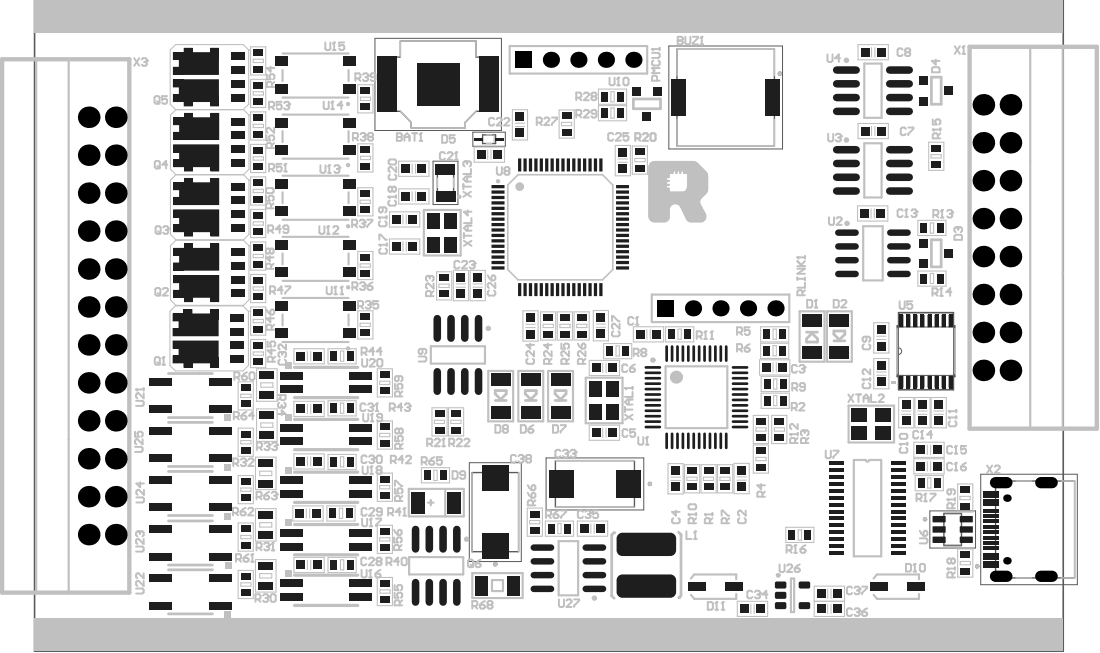
[picture p44: page 1]

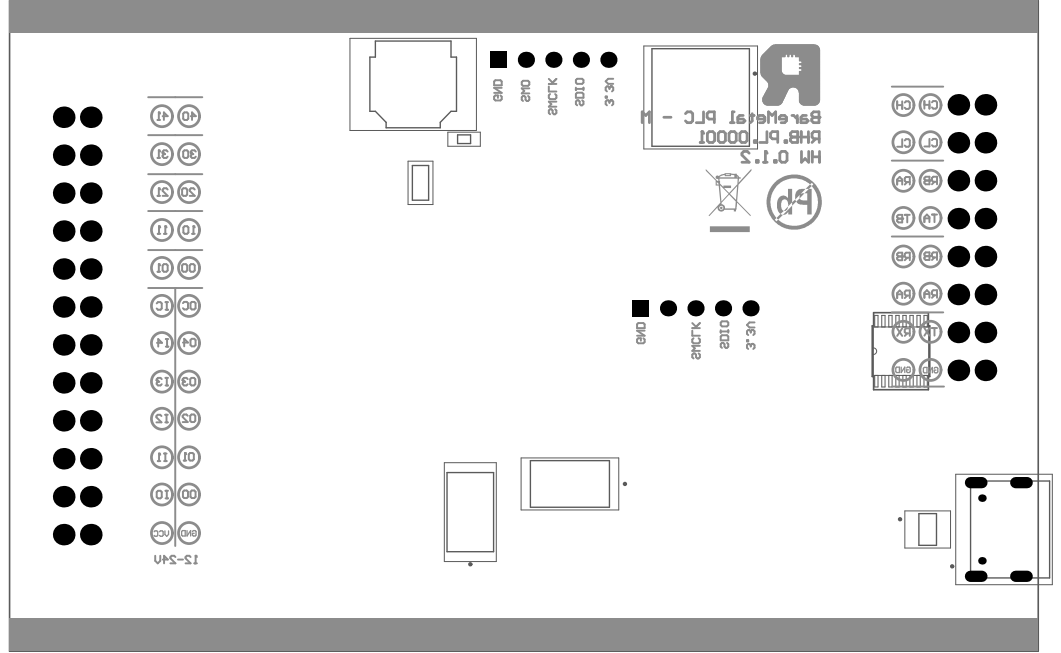
[picture p45: page 2]
