RoboticsHardwareSolutions/BareMetal-PLCs-Vault/docs/baremetal-plc-m/doc/pcb/schematic-prints.pdf

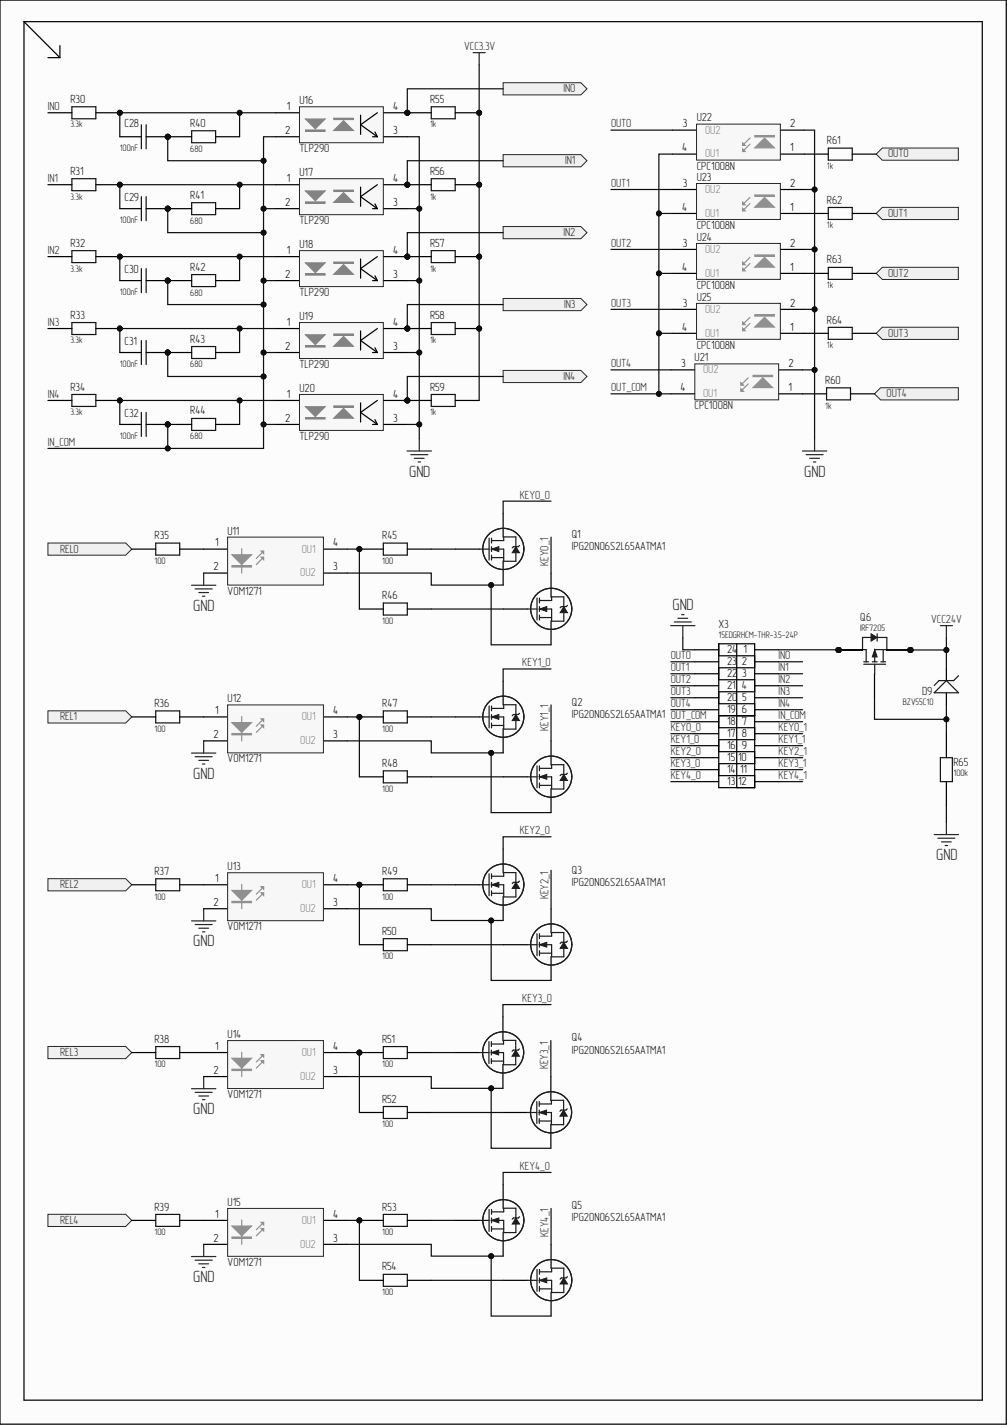
[picture p46: page 1]

23 | 2
22 | 3
21 | 4
20 | 5
19 | 6

17 | 8
16 | 9
15 | 10
14 | 11
13 | 12

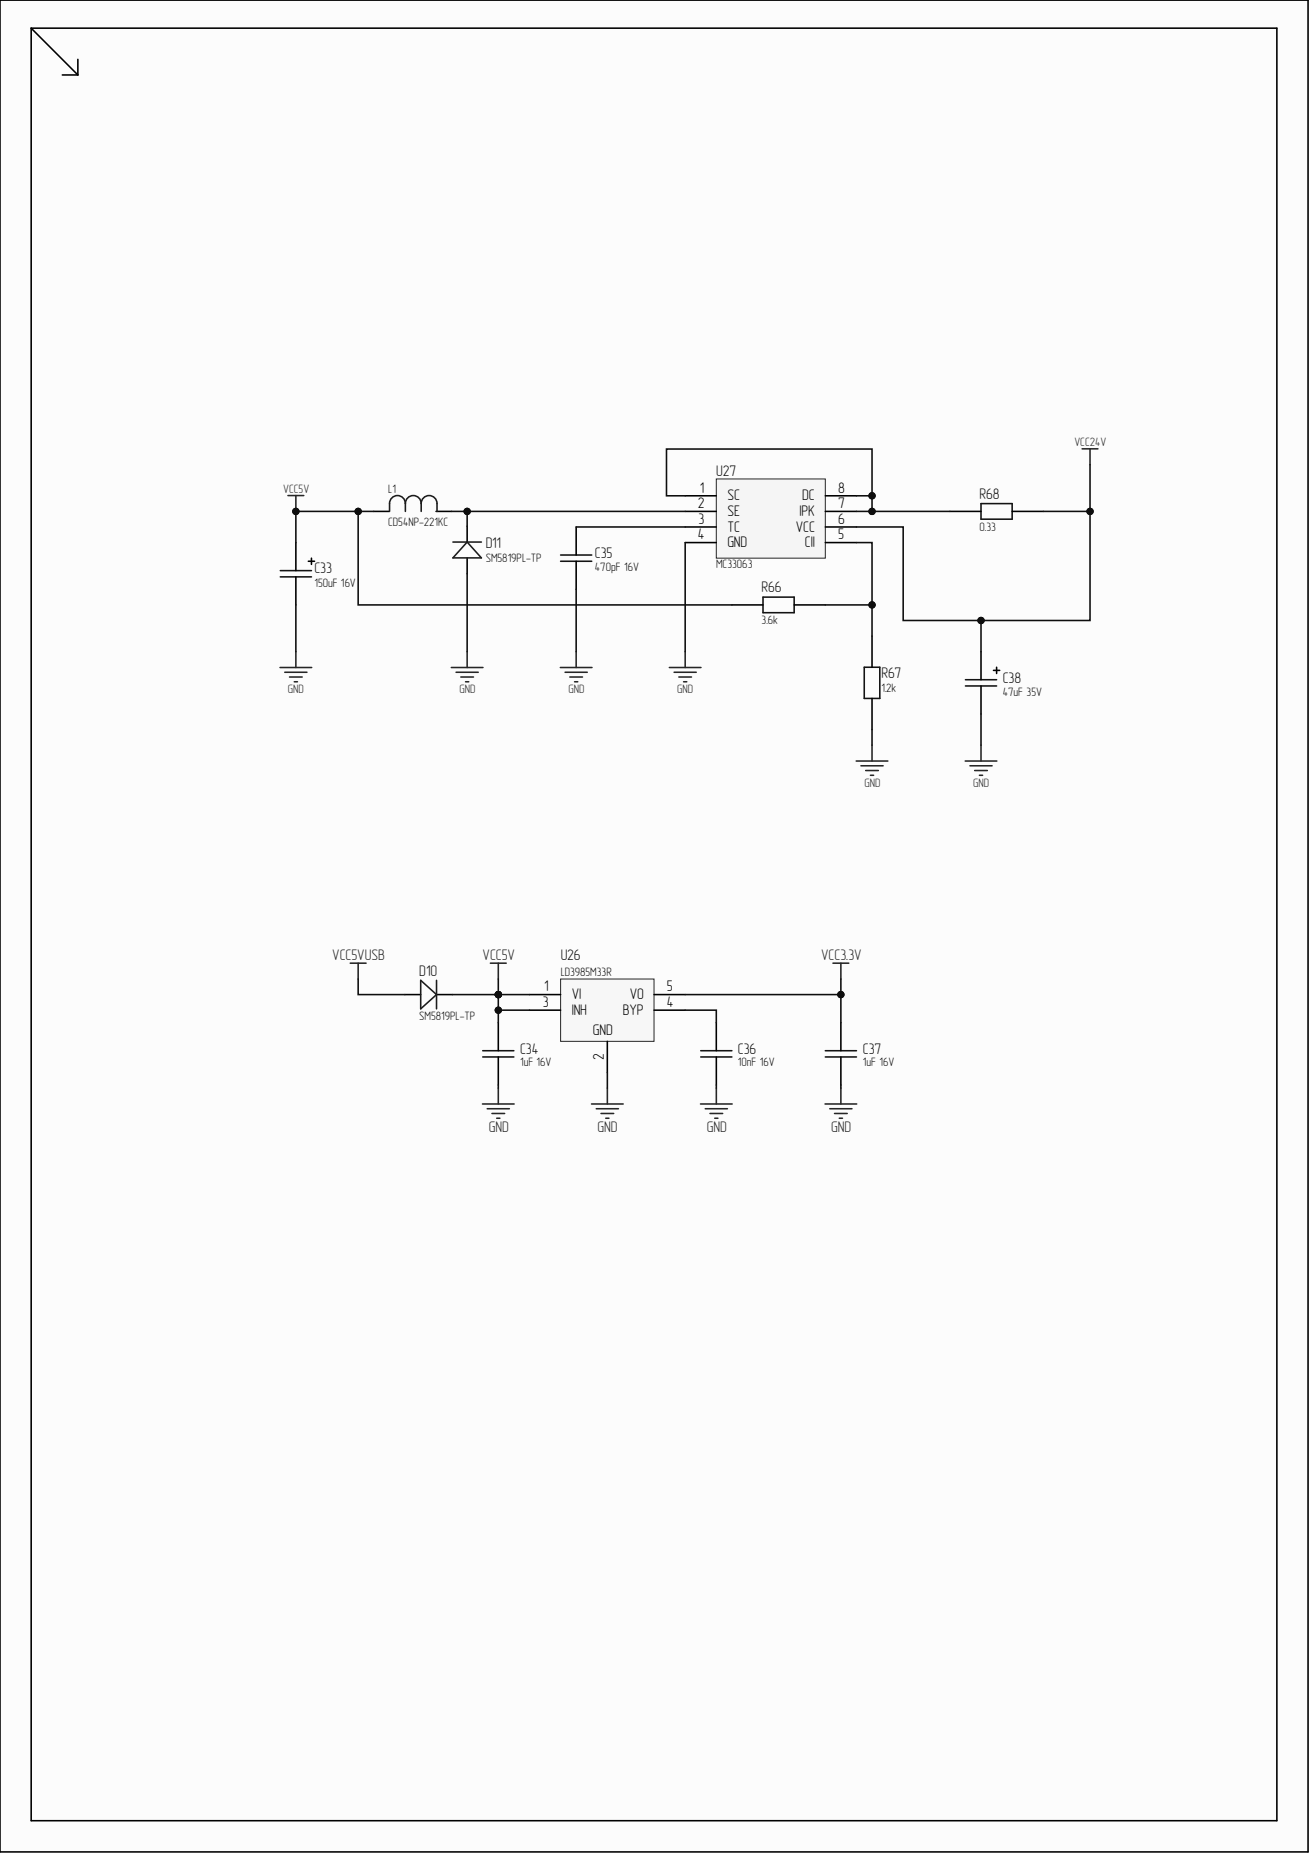
[picture p47: page 2]

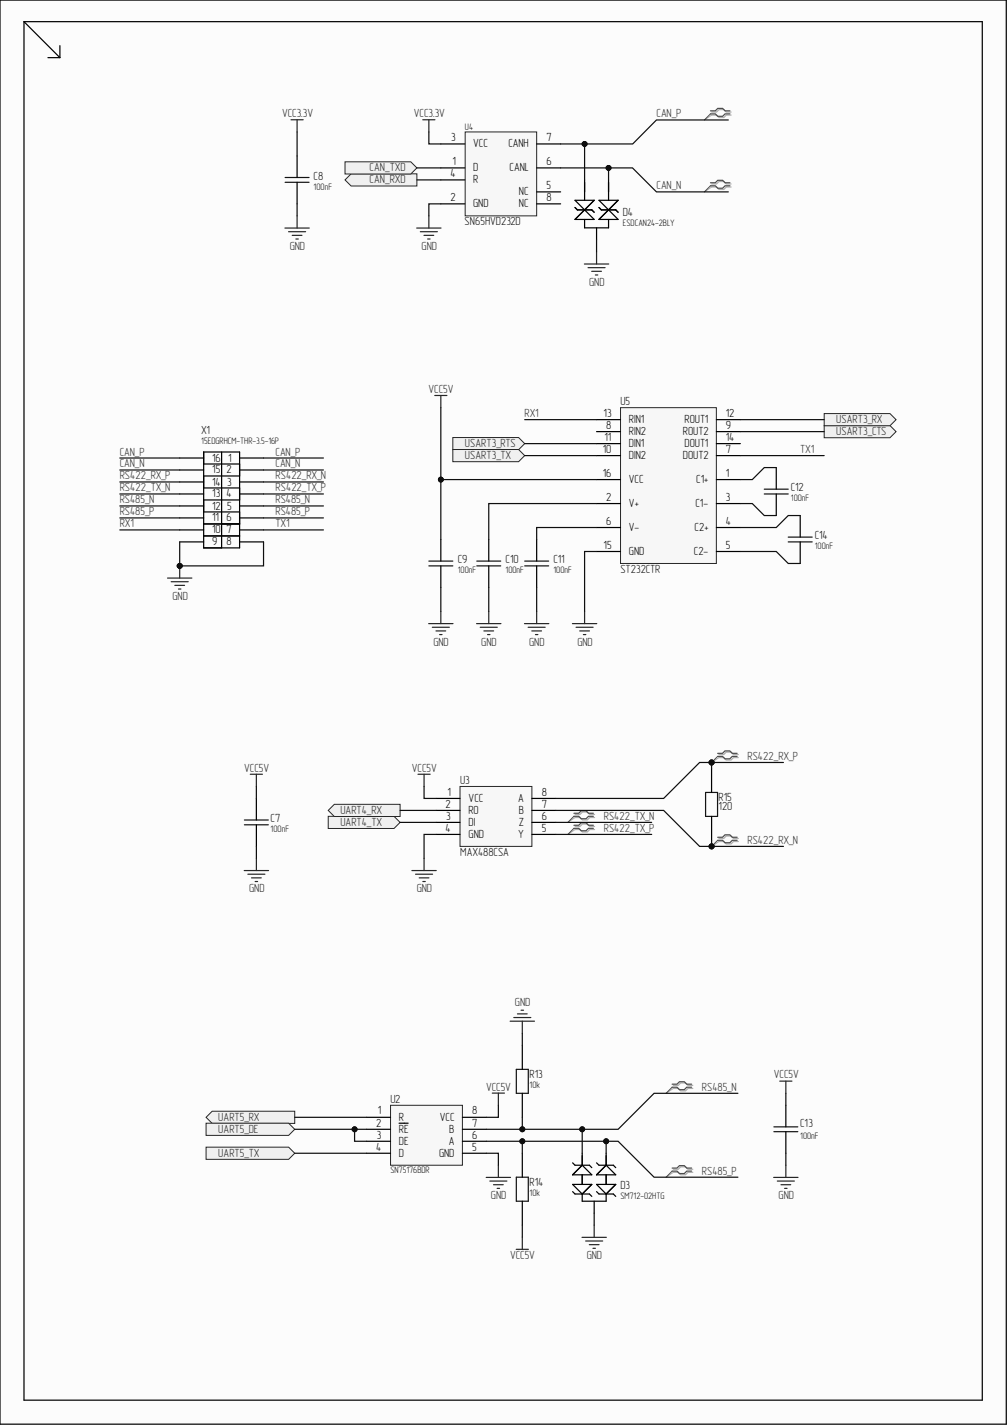
[picture p48: page 3]

15 | 2
14 | 3
13 | 4
12 | 5
11 | 6

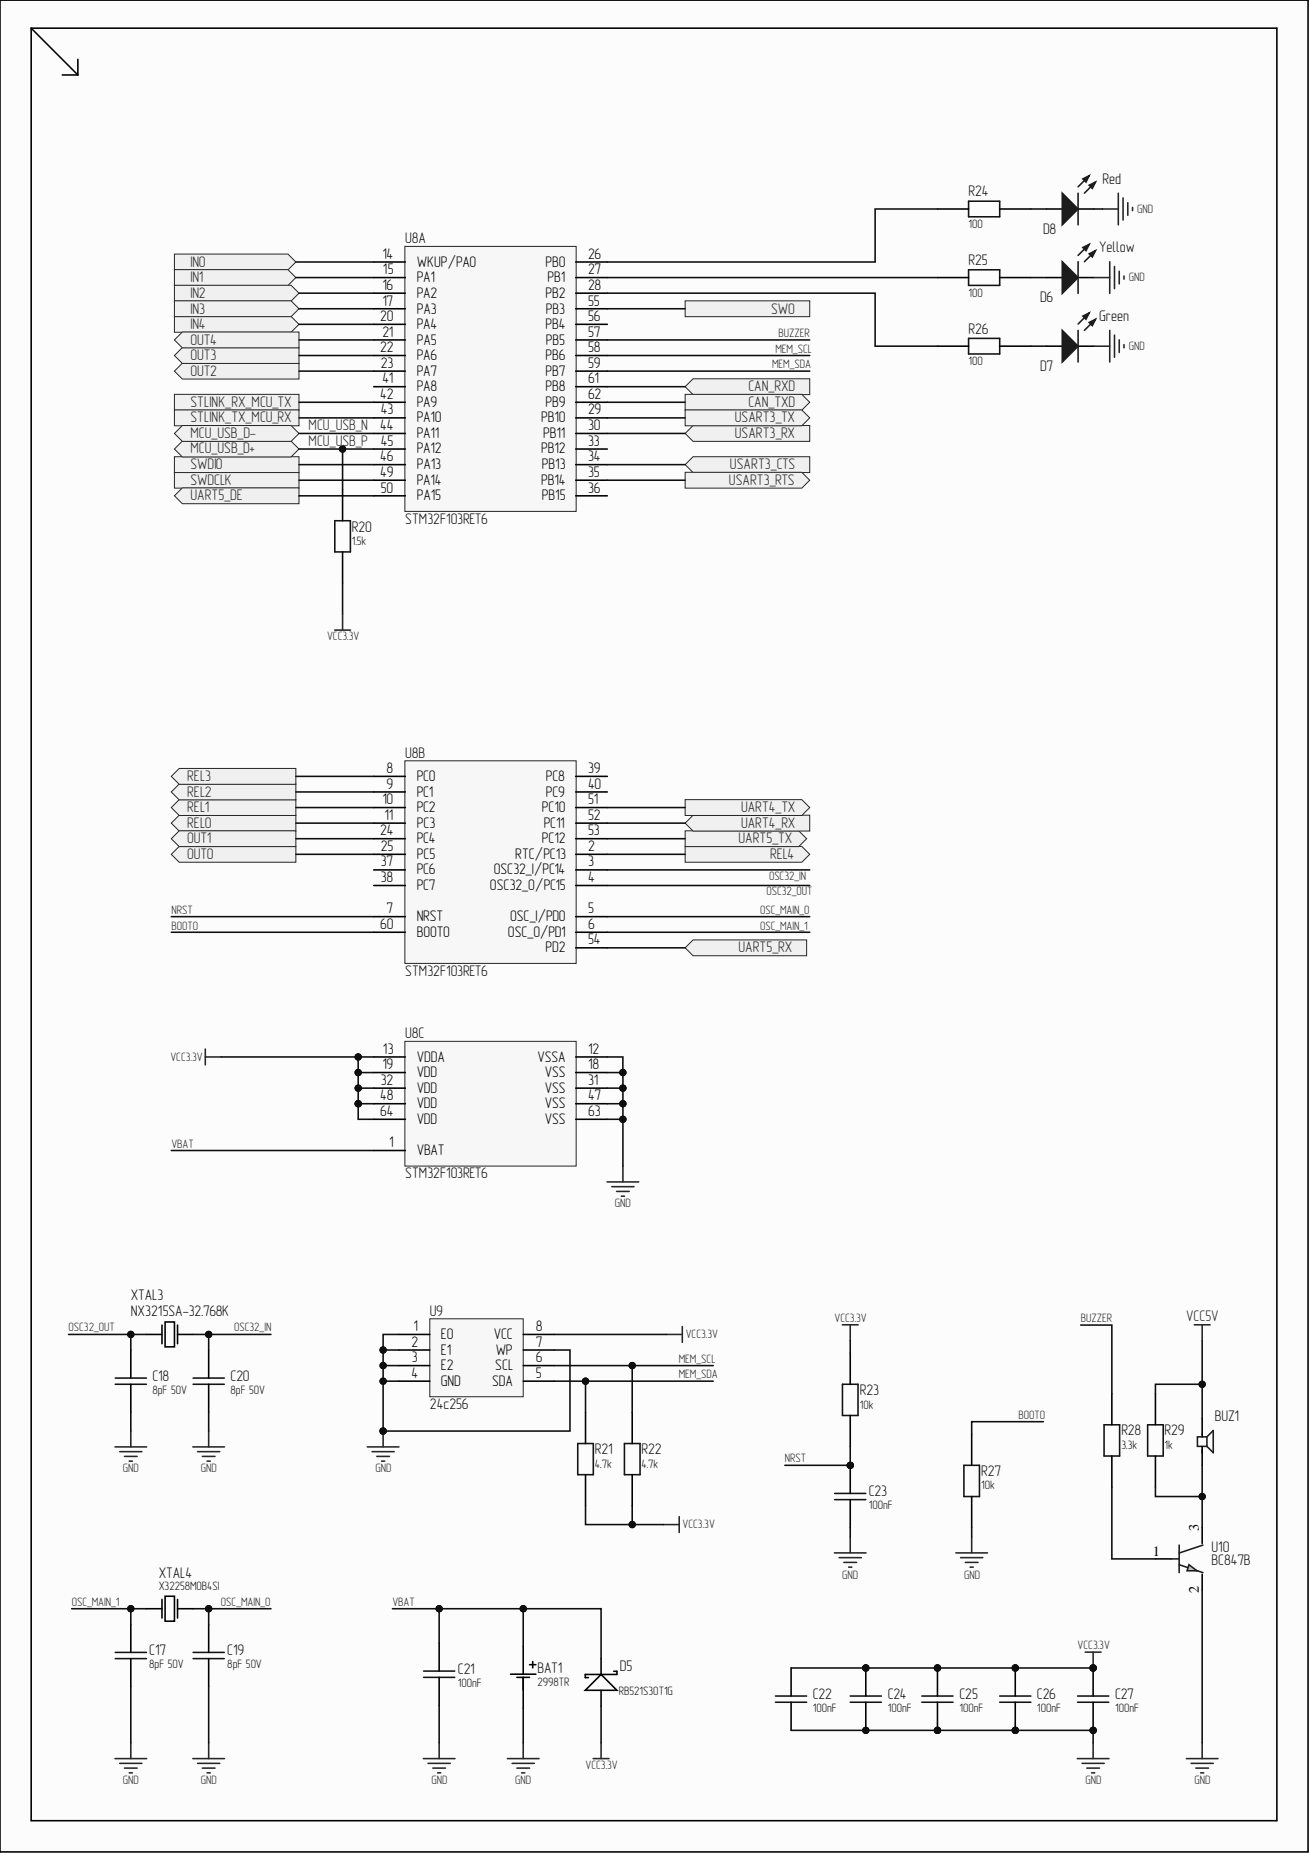
[picture p49: page 4]

E1 2
E2 3

MEM_SDA

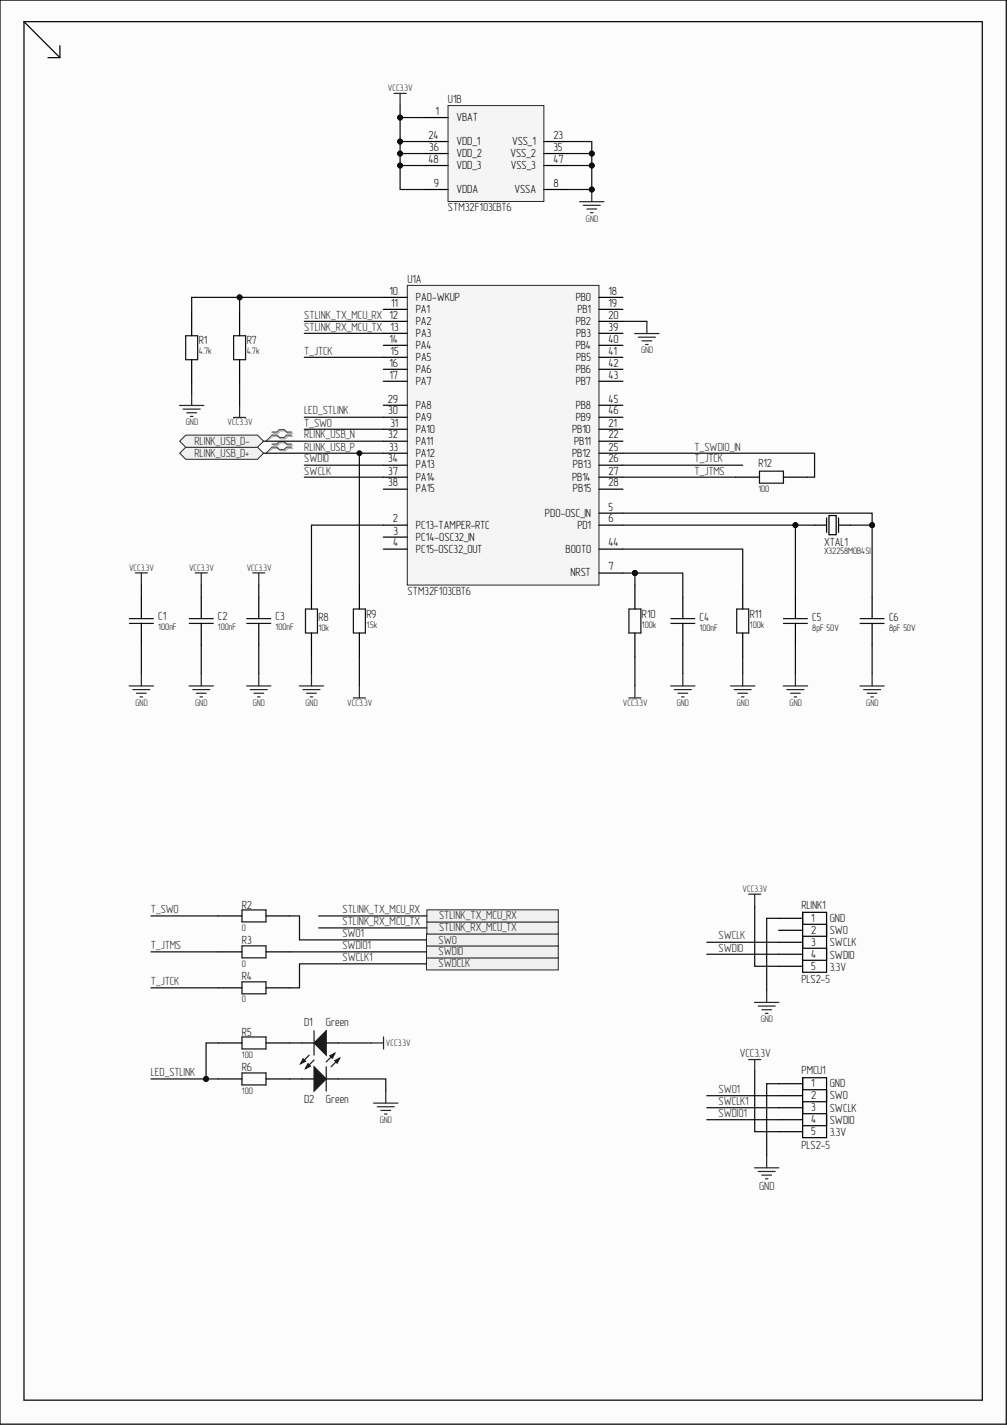
[picture p50: page 5]

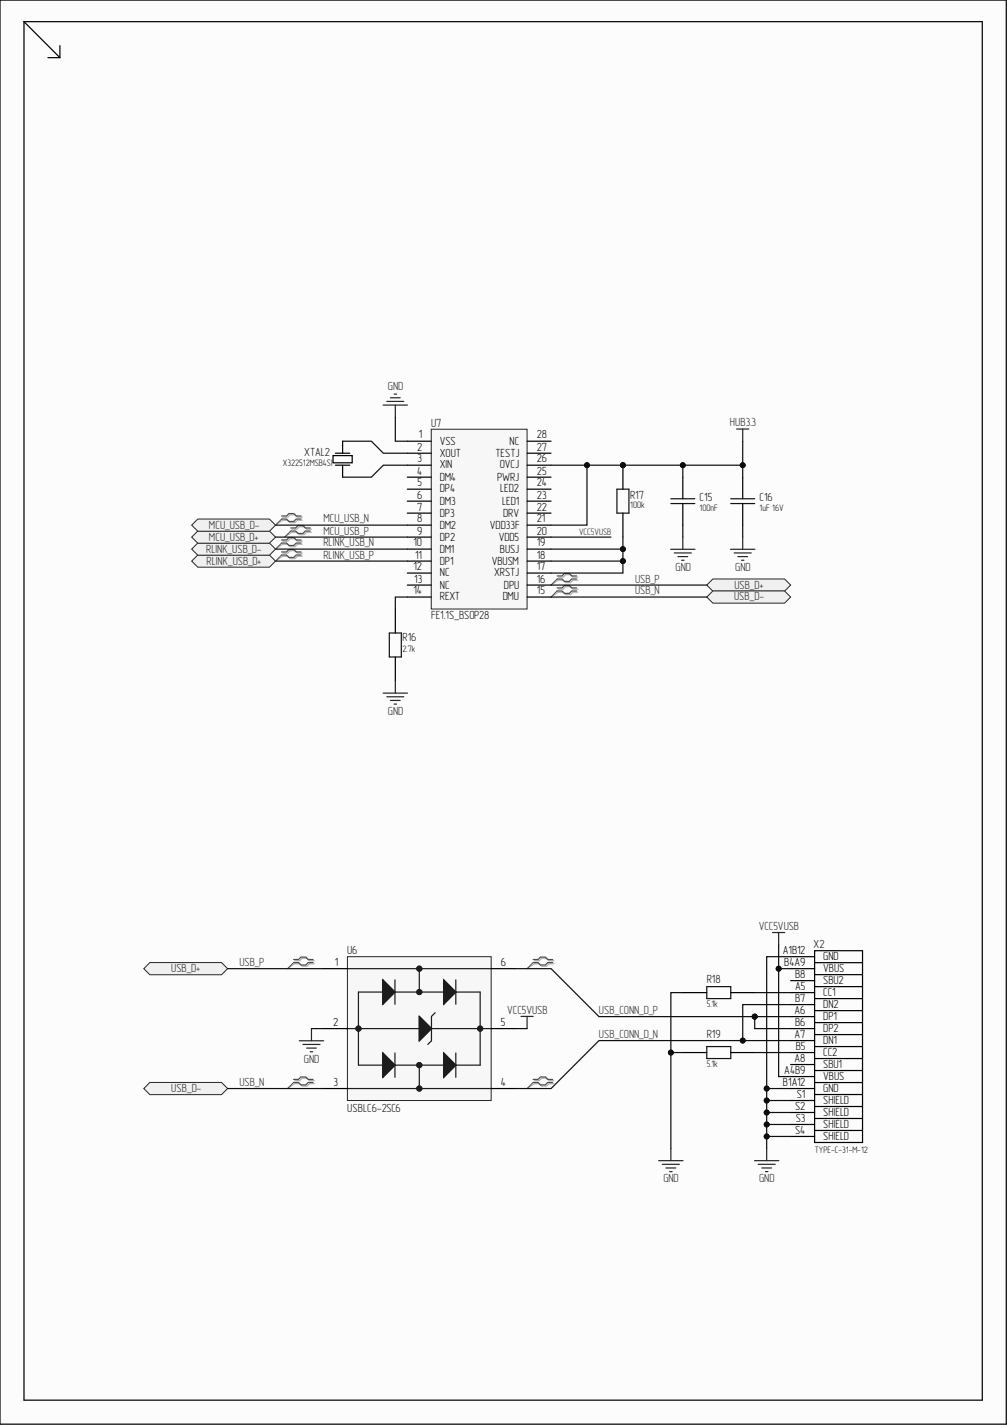
[picture p51: page 6]
