RoboticsHardwareSolutions/BareMetal-PLCs-Vault/docs/baremetal-plc-xl/doc/pcb/assembly-drawings.pdf

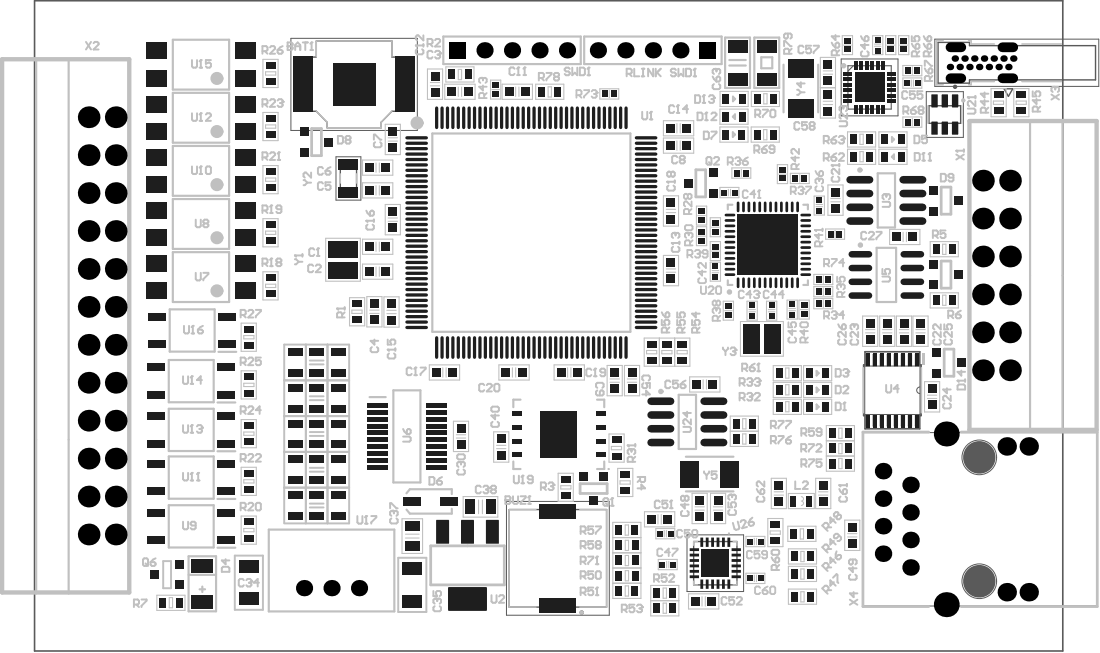
[picture p52: page 1]

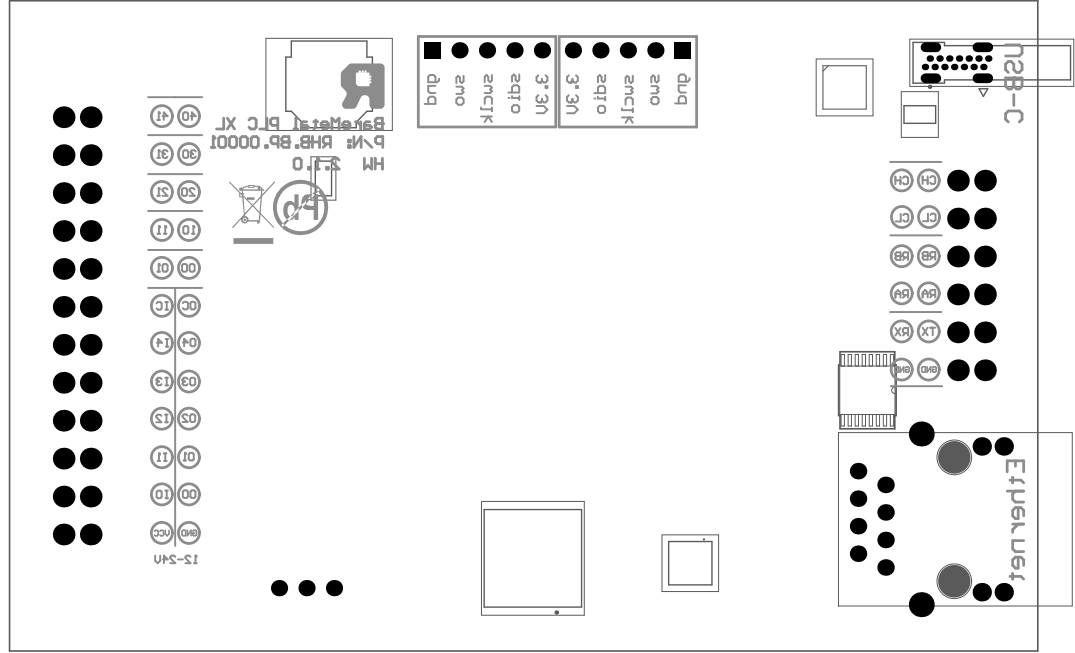
[picture p53: page 2]
