RoboticsHardwareSolutions/BareMetal-PLCs-Vault/docs/baremetal-plc-xl/doc/pcb/schematic-prints.pdf

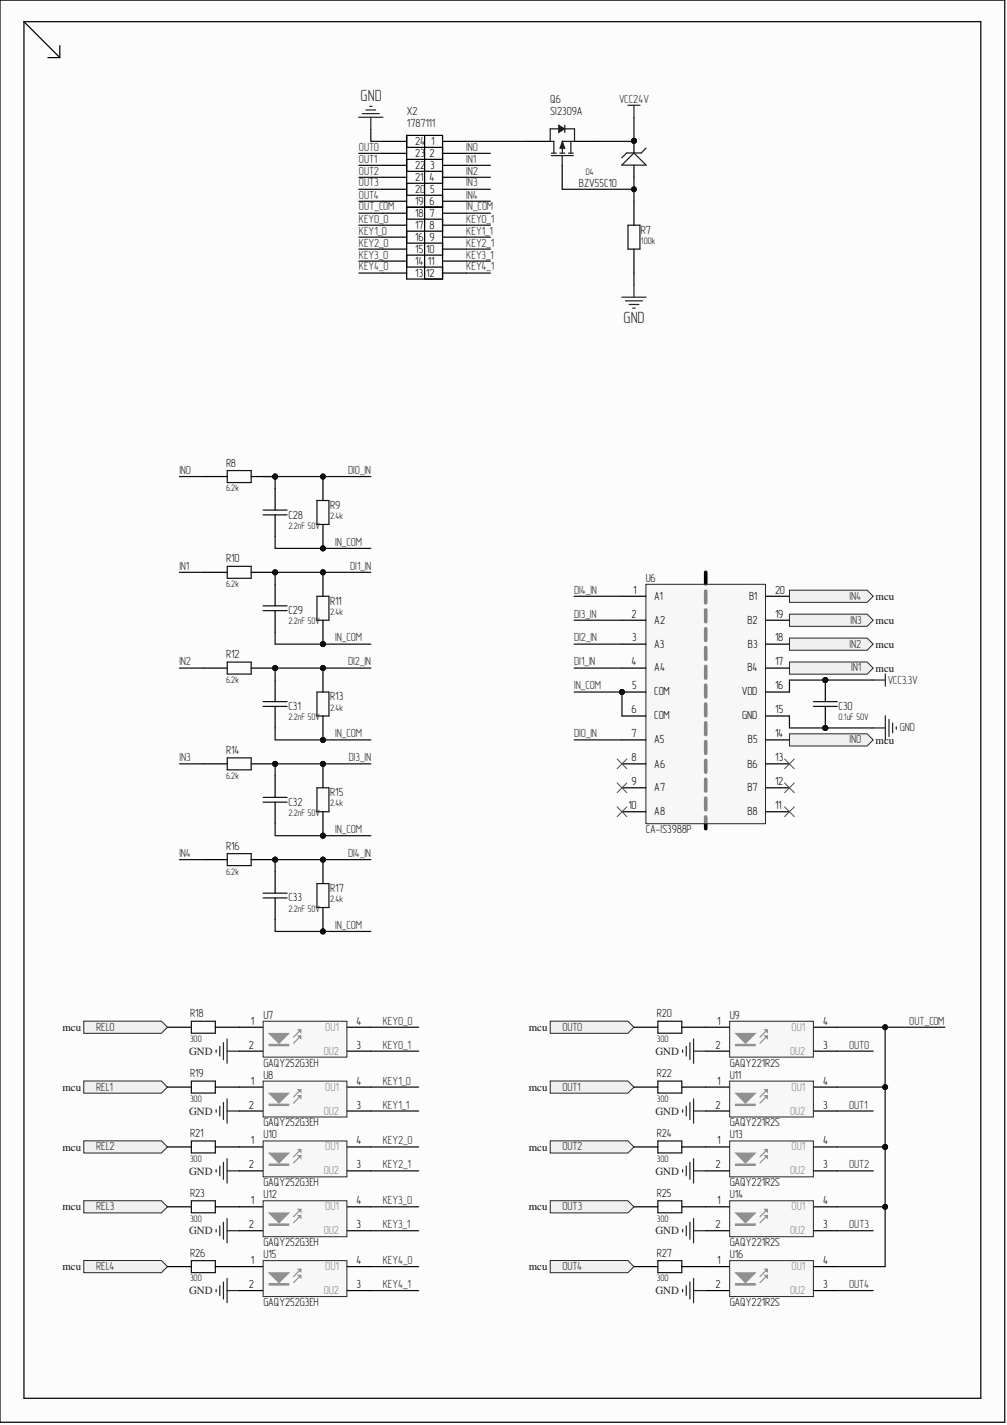
[picture p54: page 1]

24 | 1
23 | 2
22 | 3
21 | 4
20 | 5
19 | 6
18 | 7
17 | 8
16 | 9
15 | 10
14 | 11
13 | 12

COM 6

IN_COM

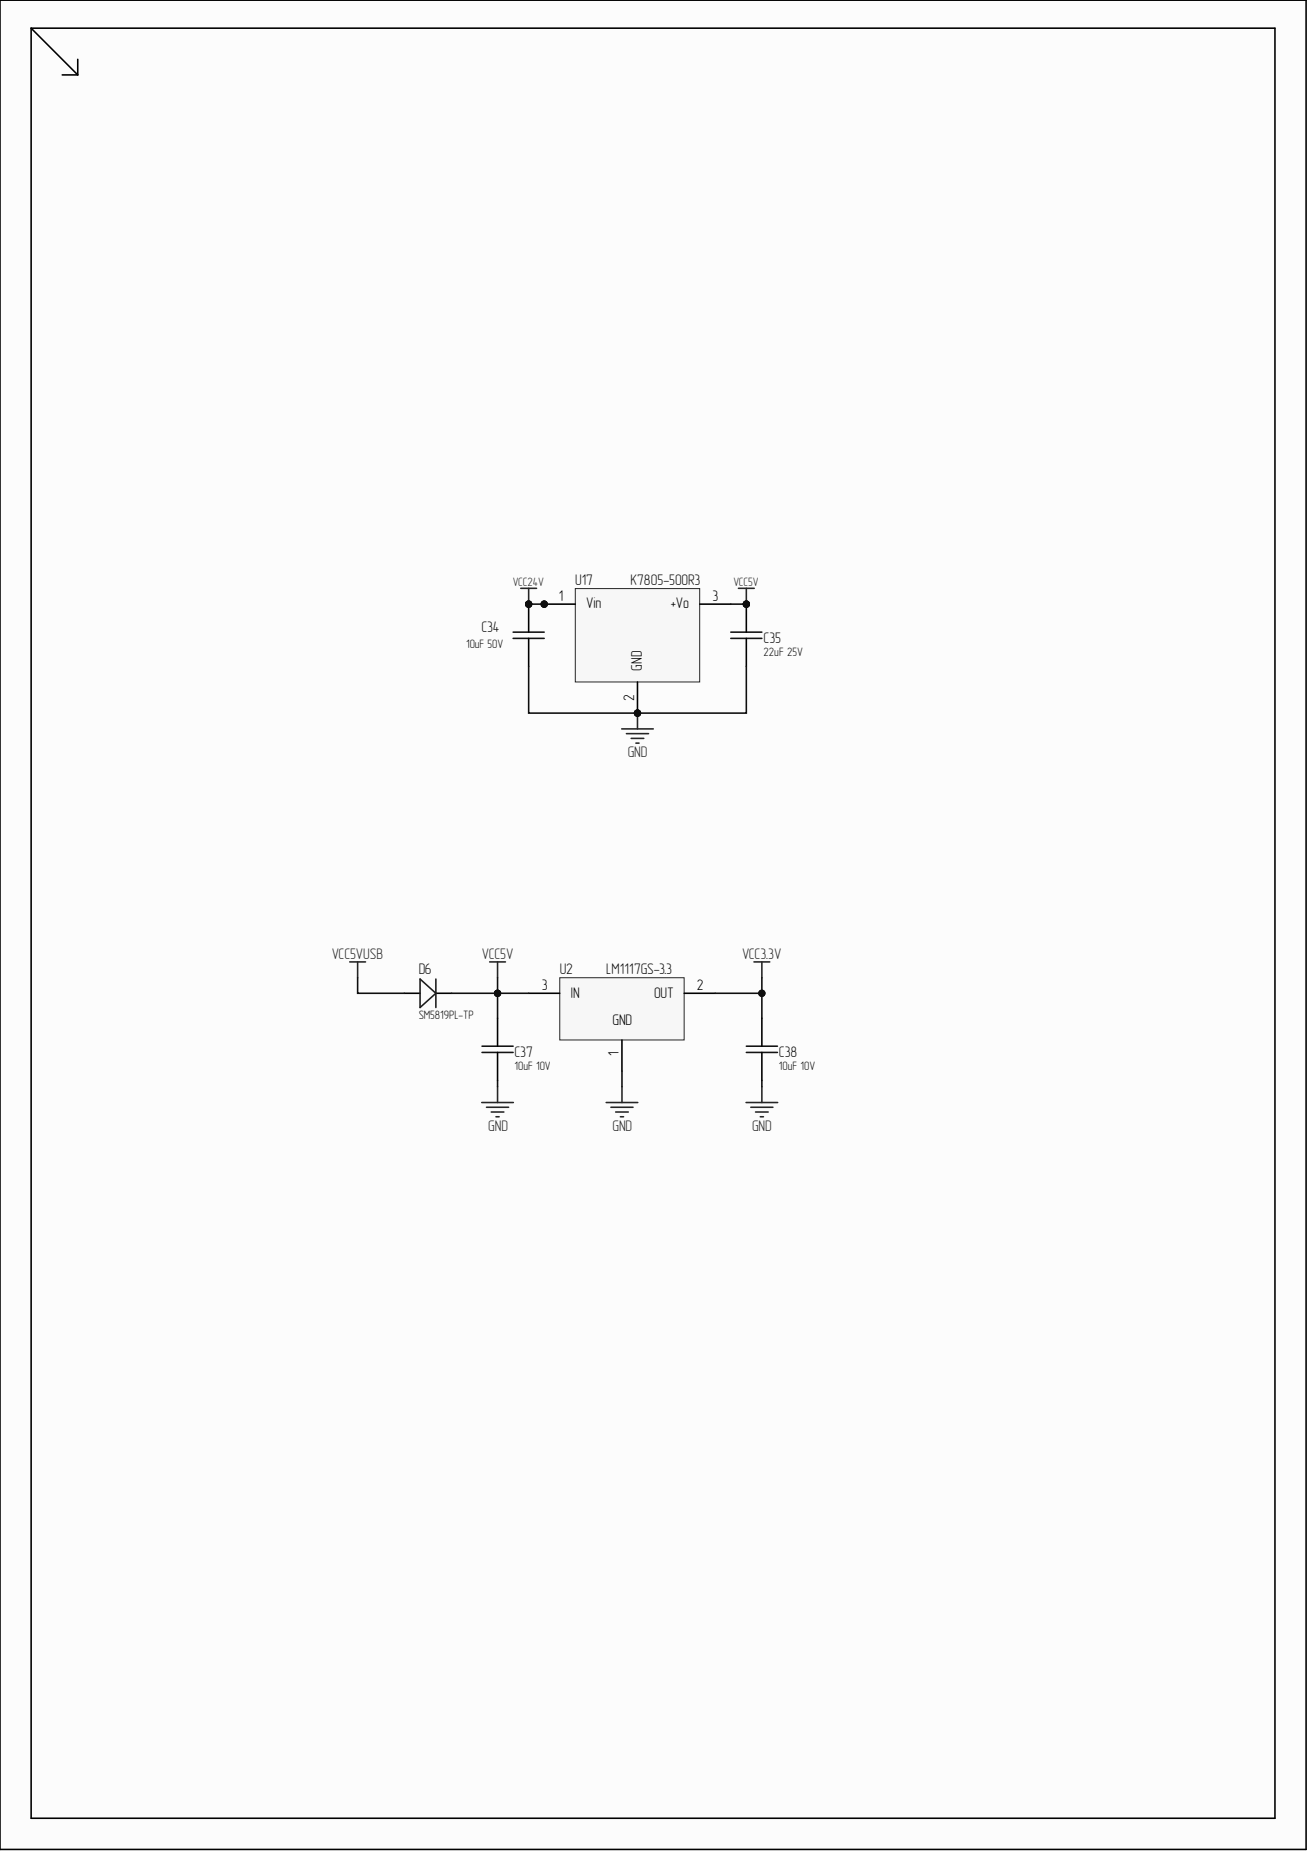
[picture p55: page 2]

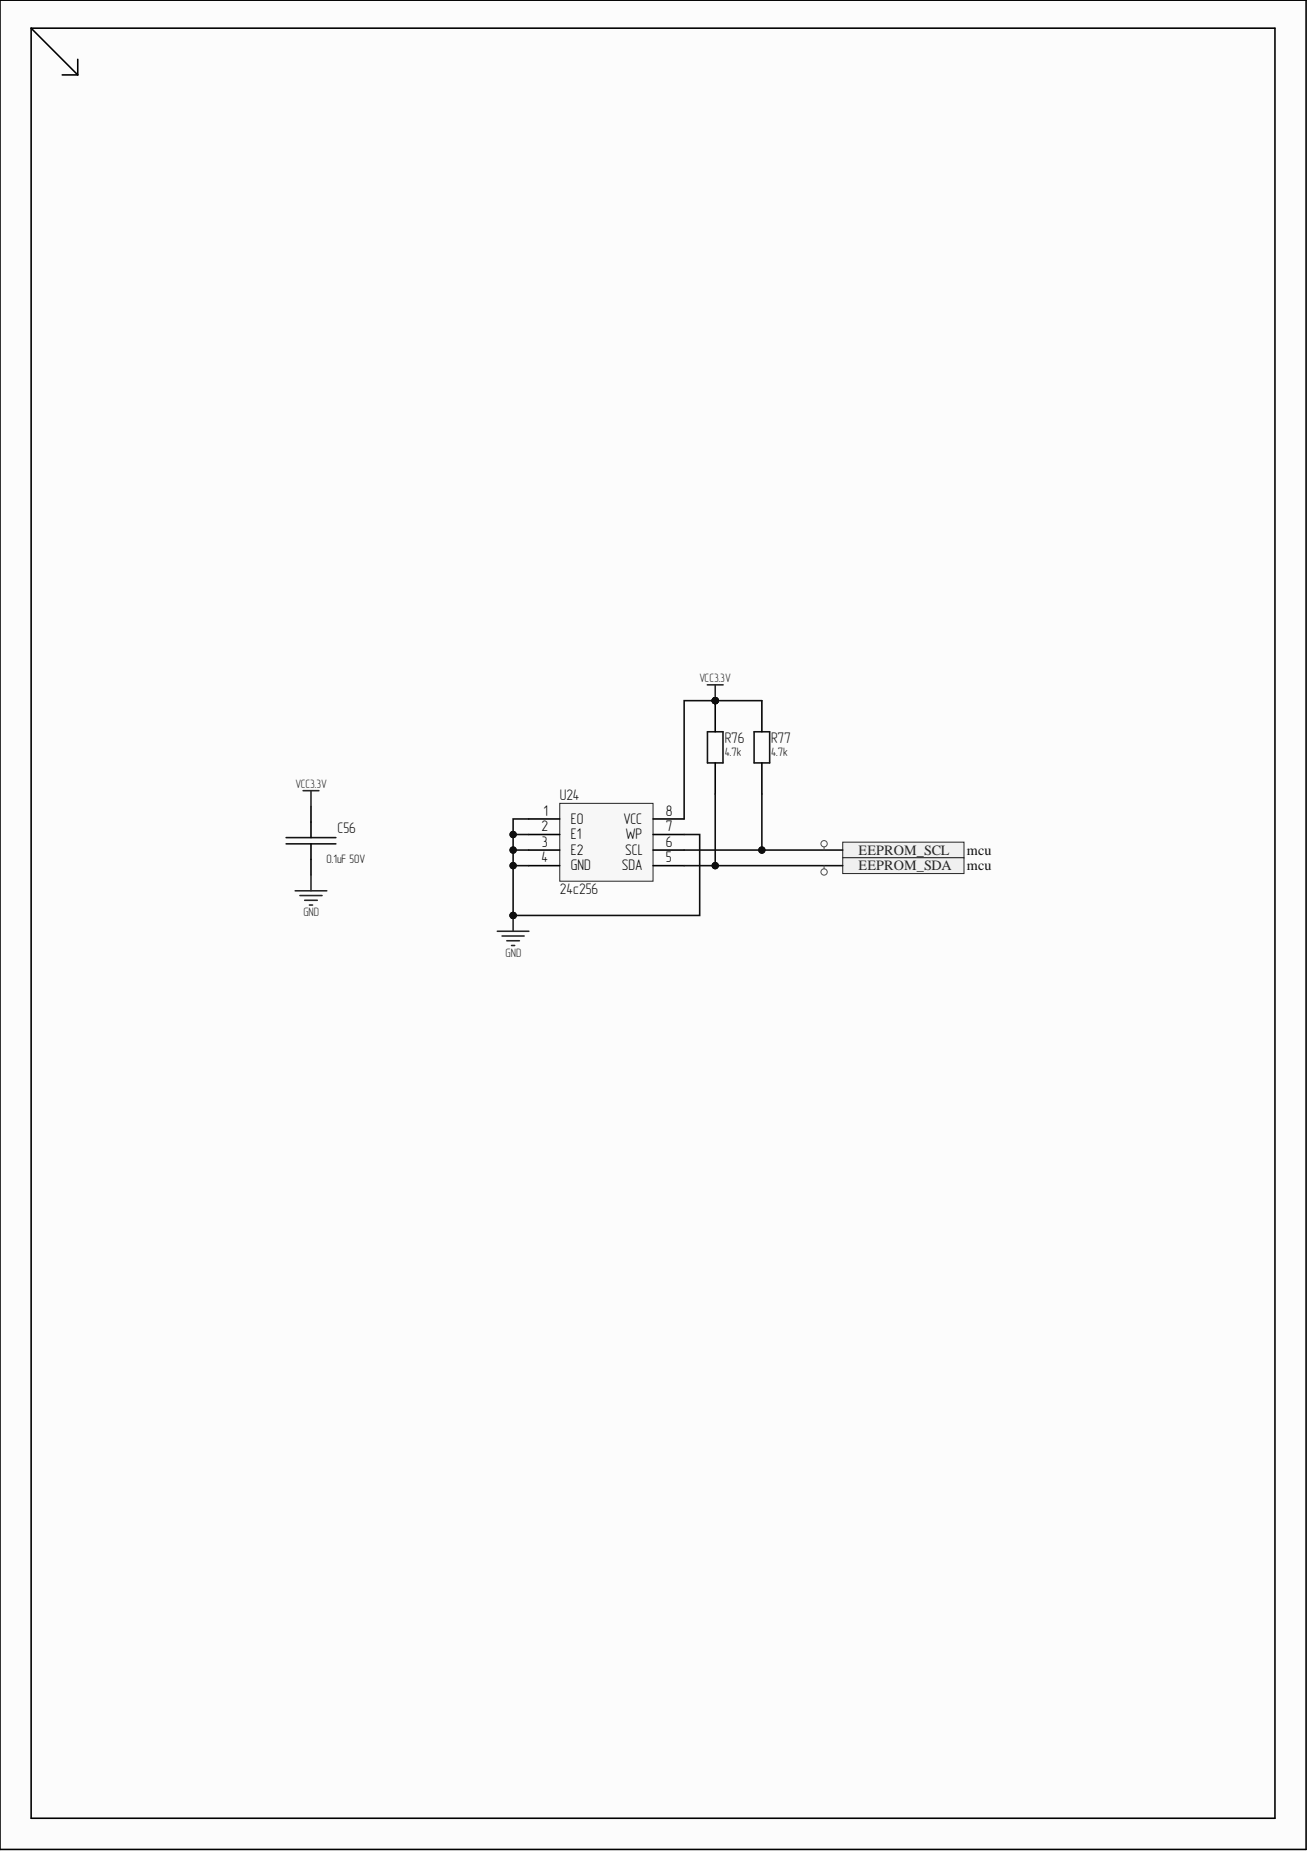
[picture p56: page 3]

2 | | 5 SCL 6 WP 7 VCC 8

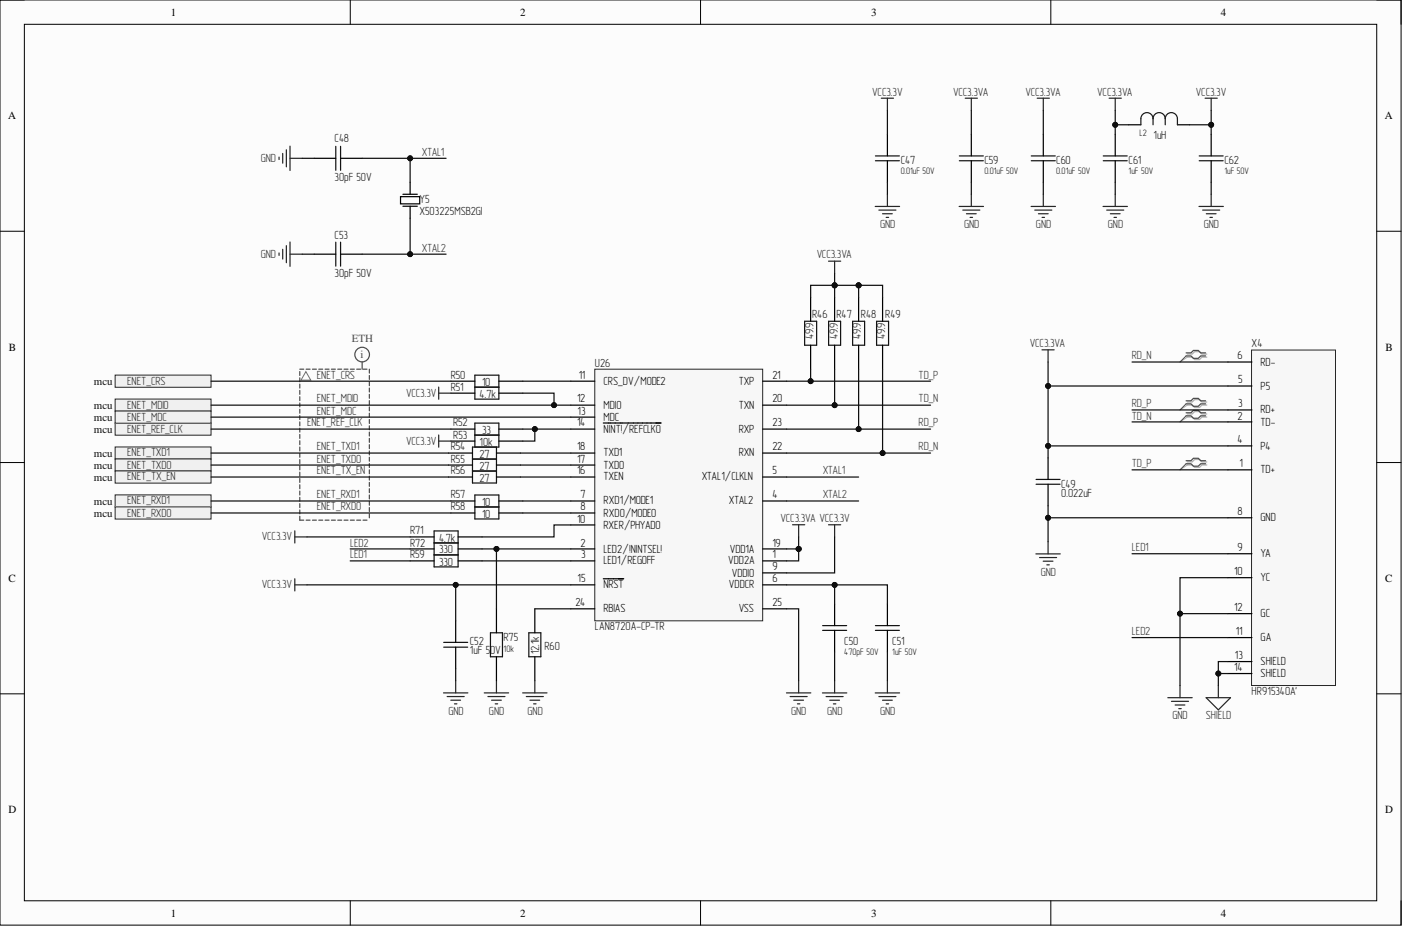
[picture p57: page 4]

ENET_ M D I O
ENET_ M D C | 1 3
ENET_RE F _ C L K

ENET_TX D 1

1 3
1 4

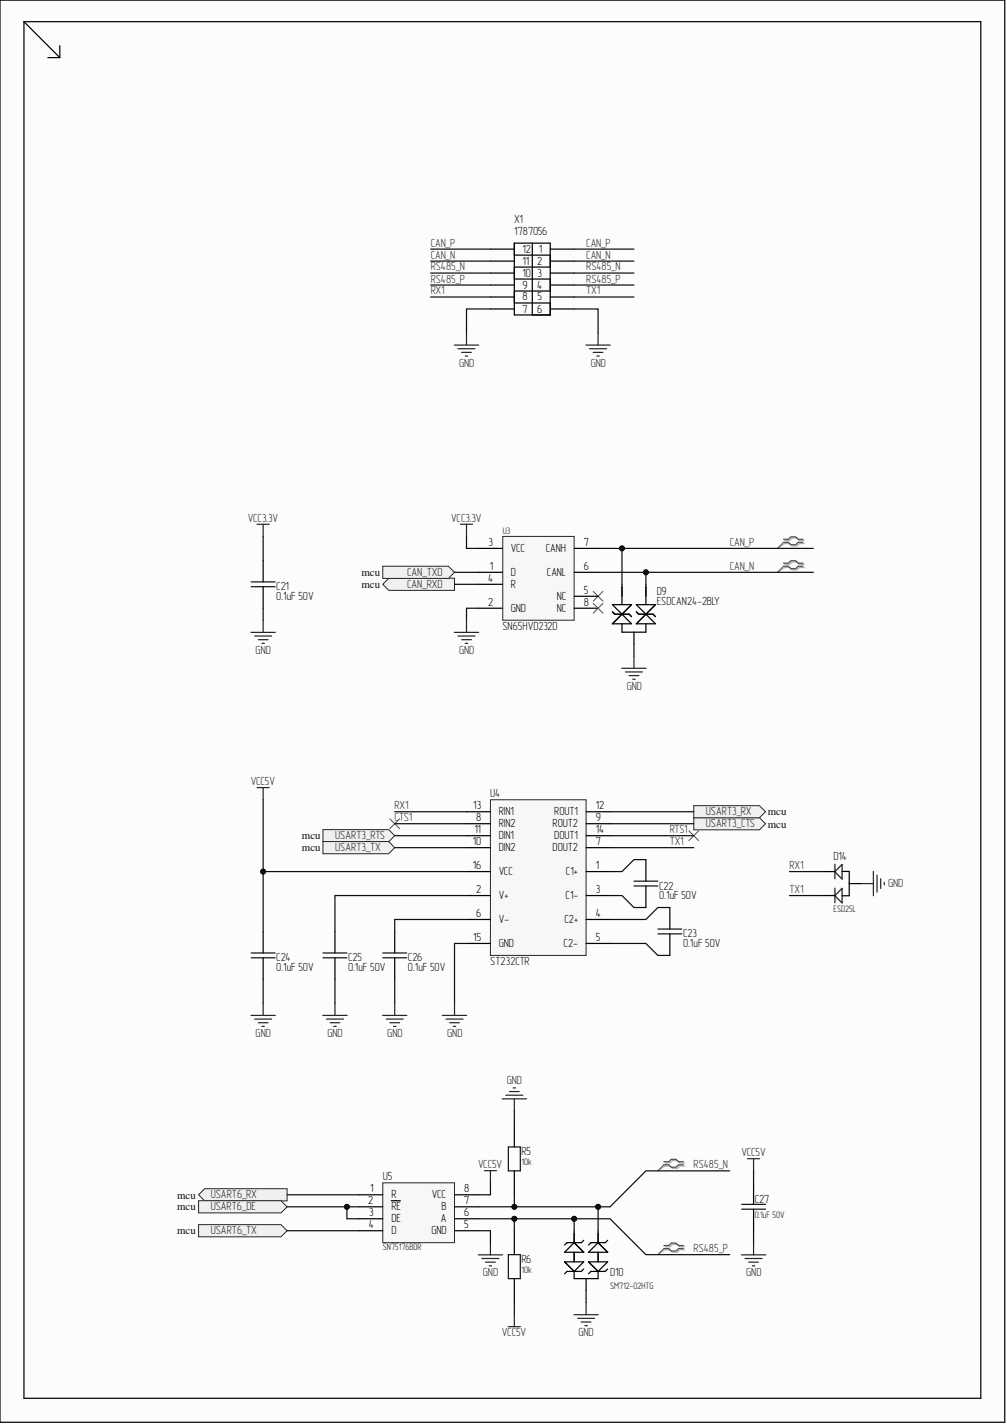
[picture p58: page 5]

12 | 1
11 | 2
10 | 3

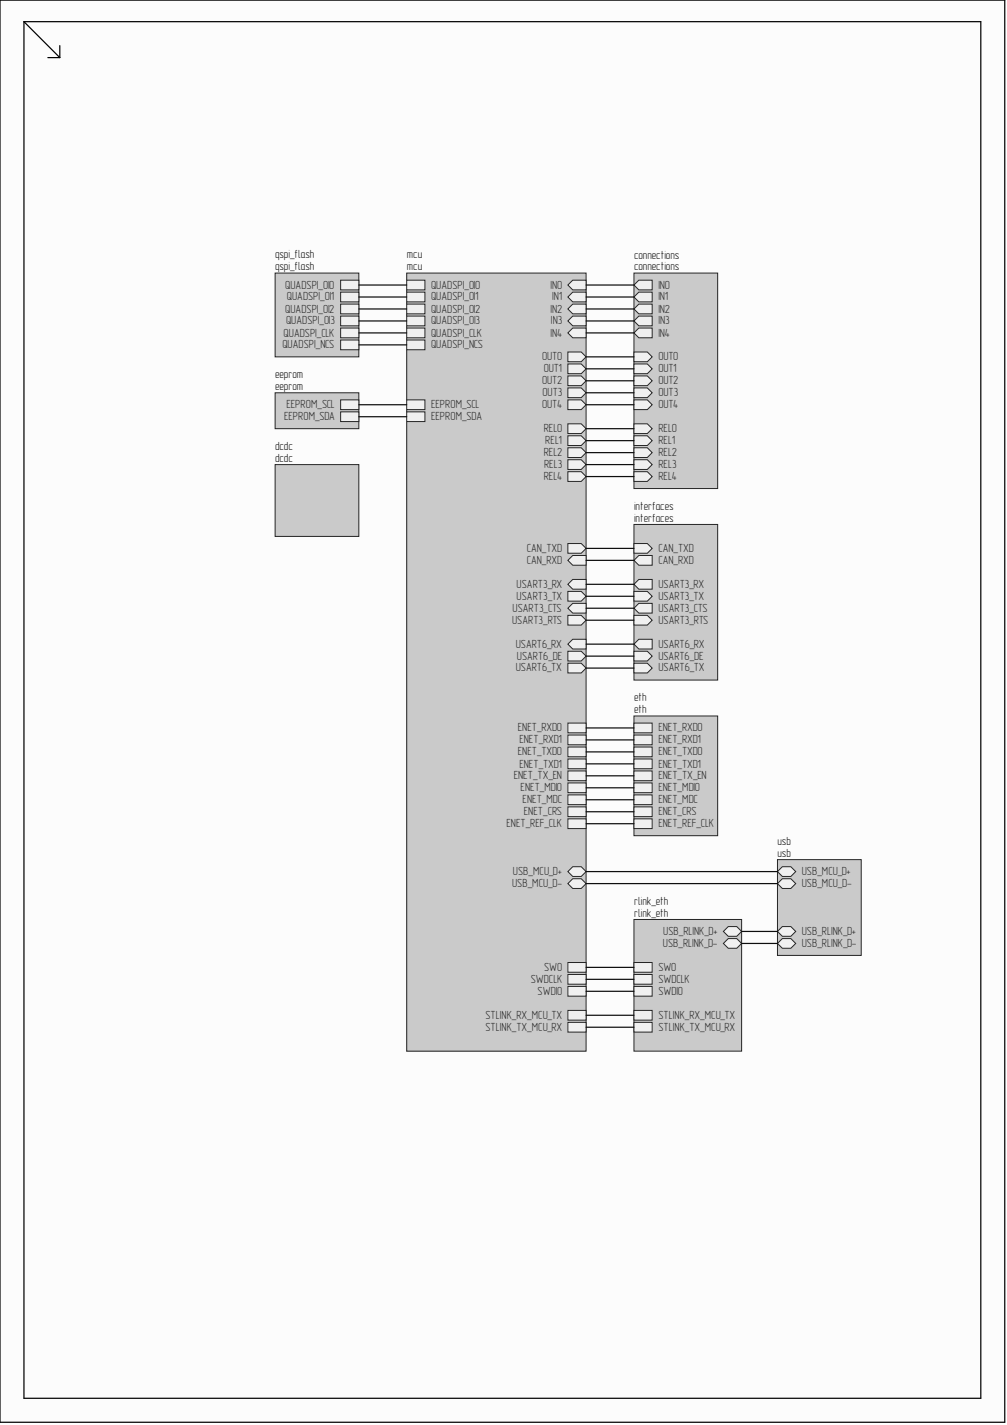
[picture p59: page 6]

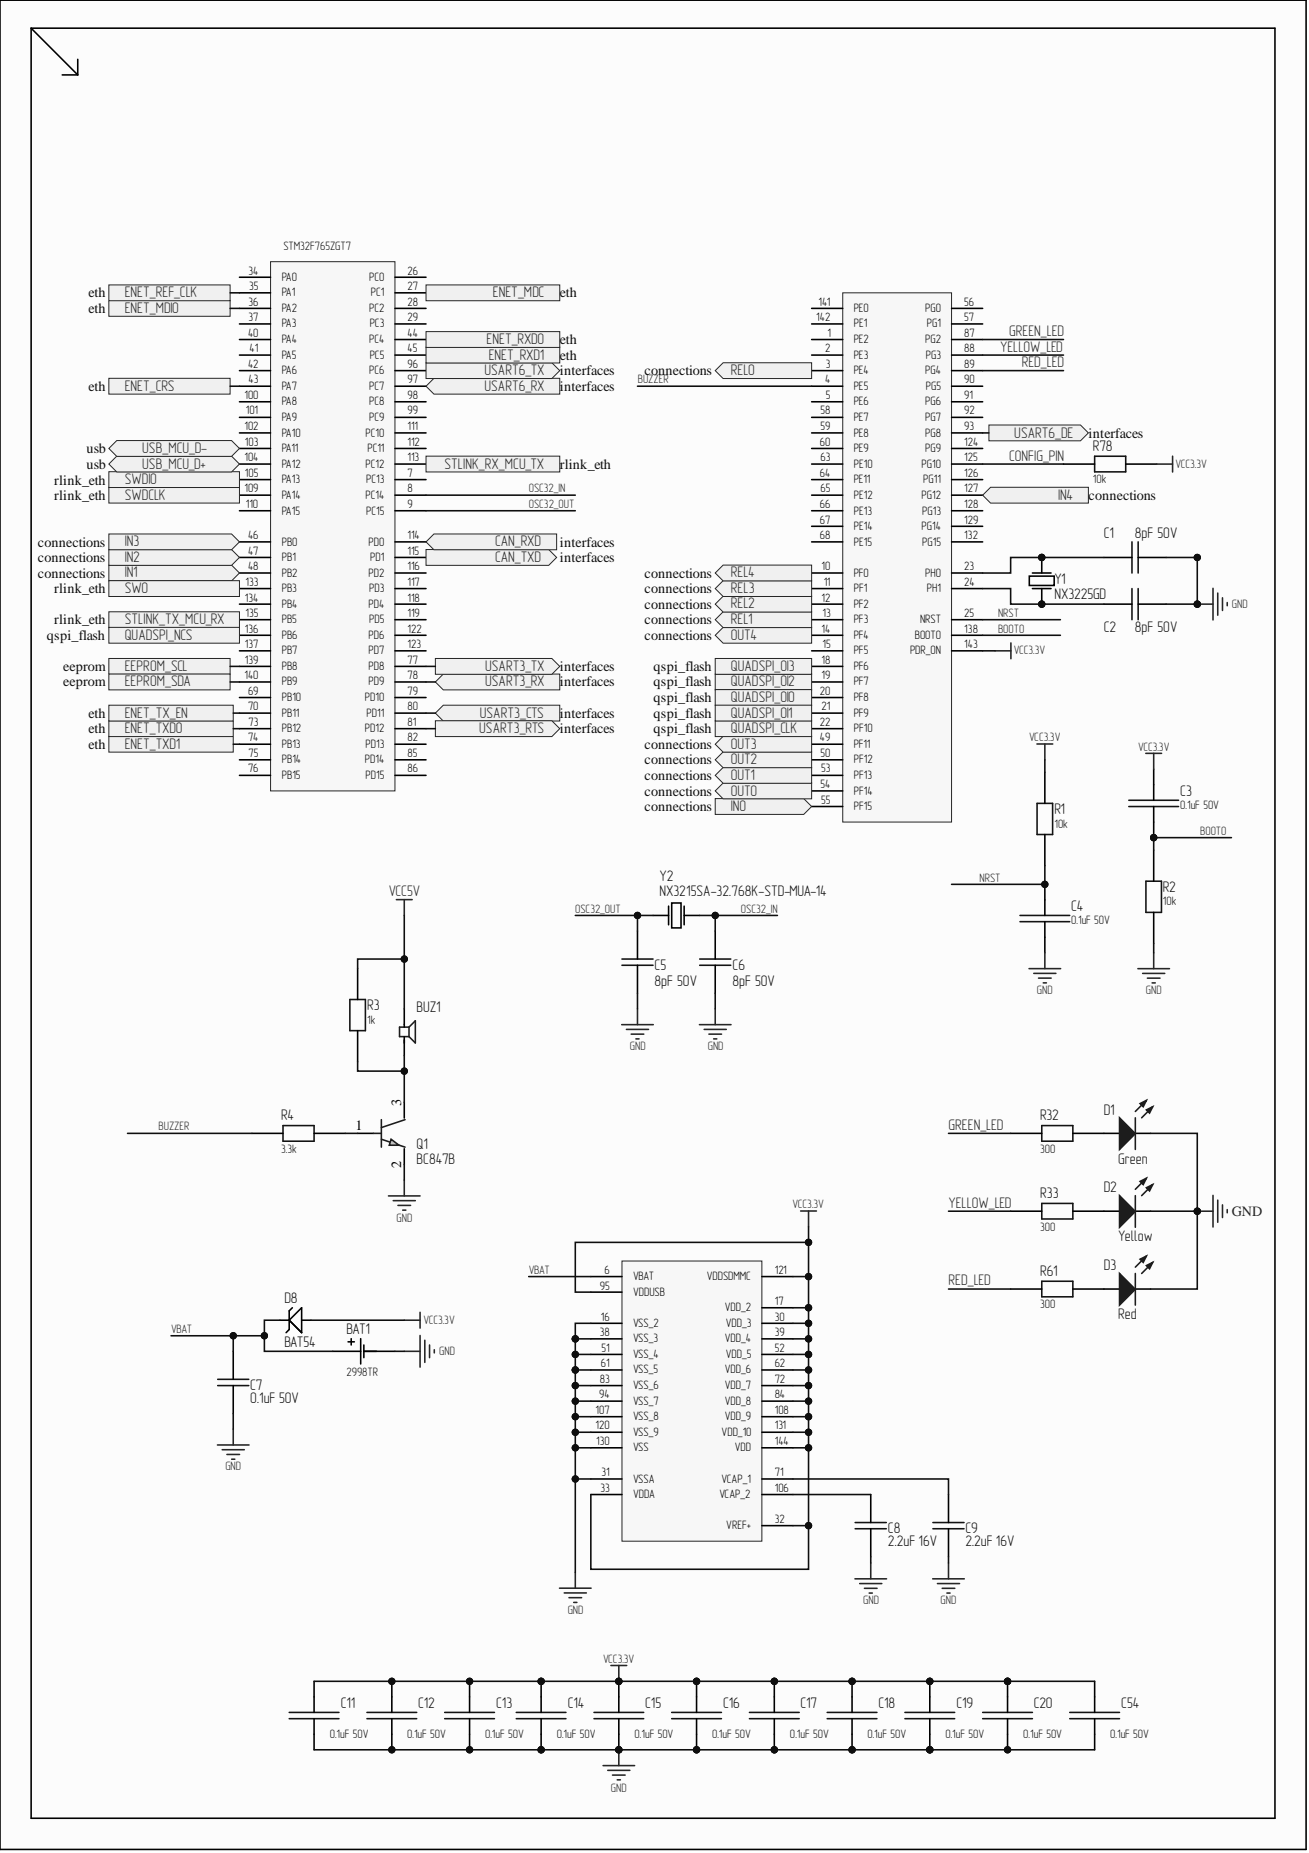
[picture p60: page 7]

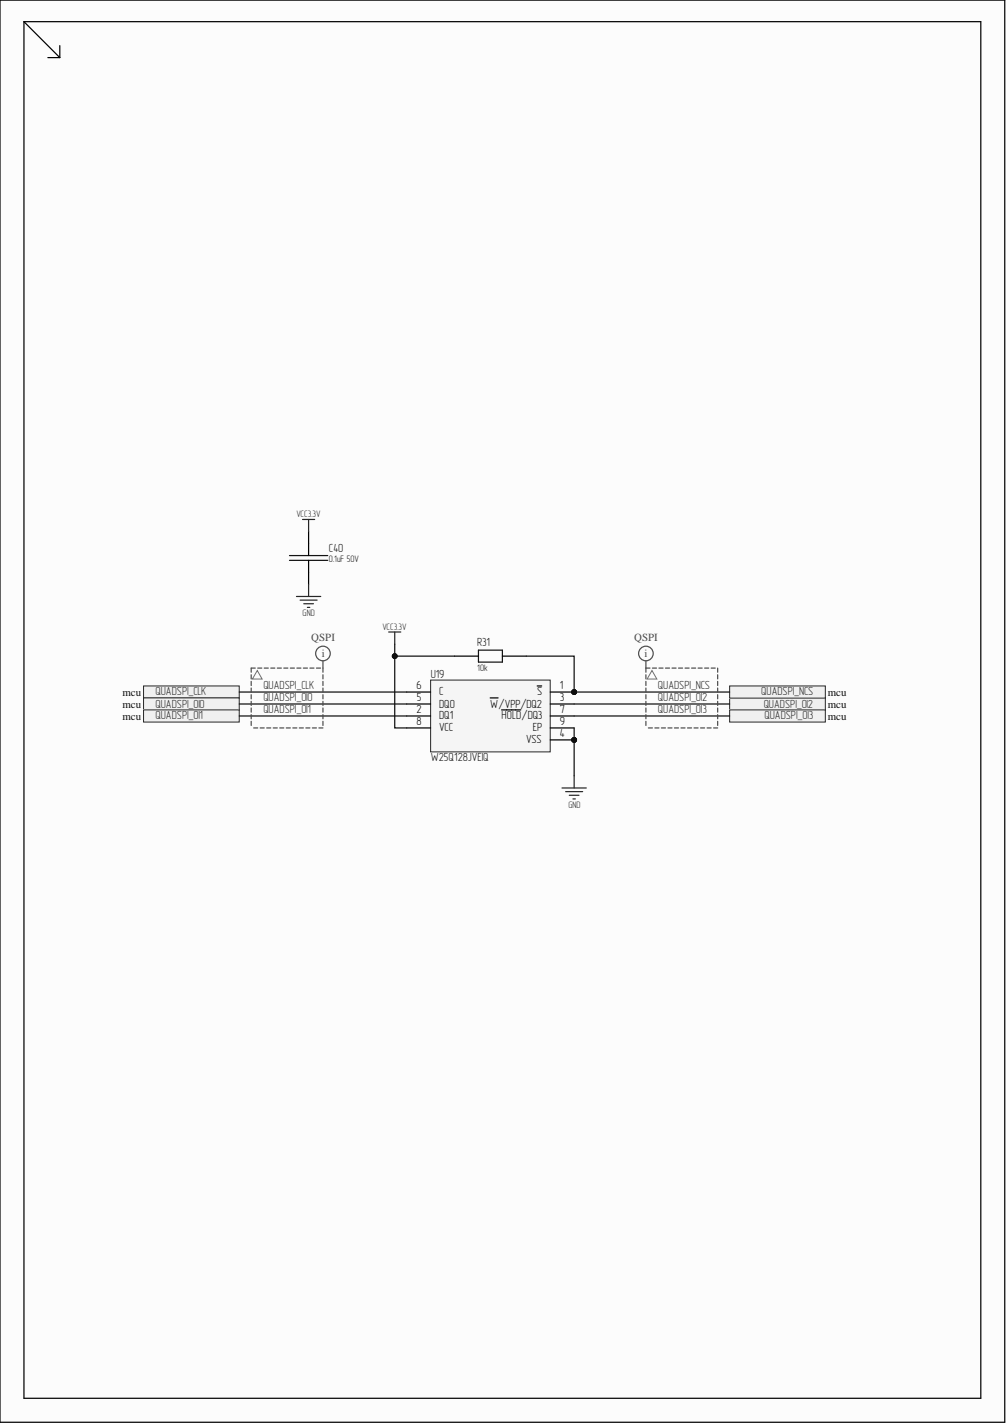
[picture p61: page 8]

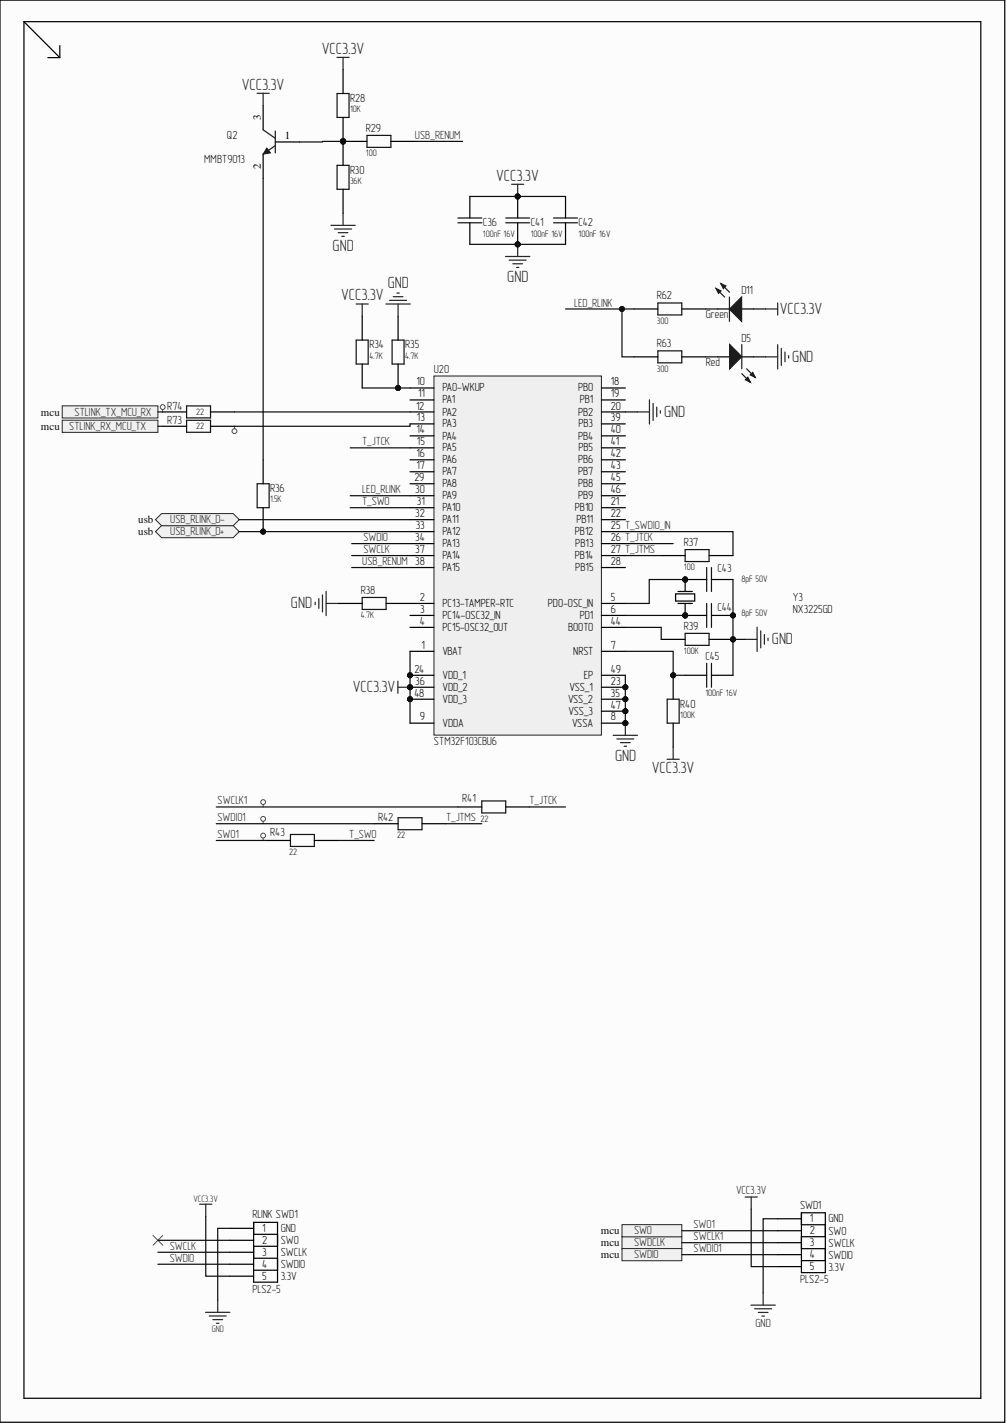
[picture p62: page 9]

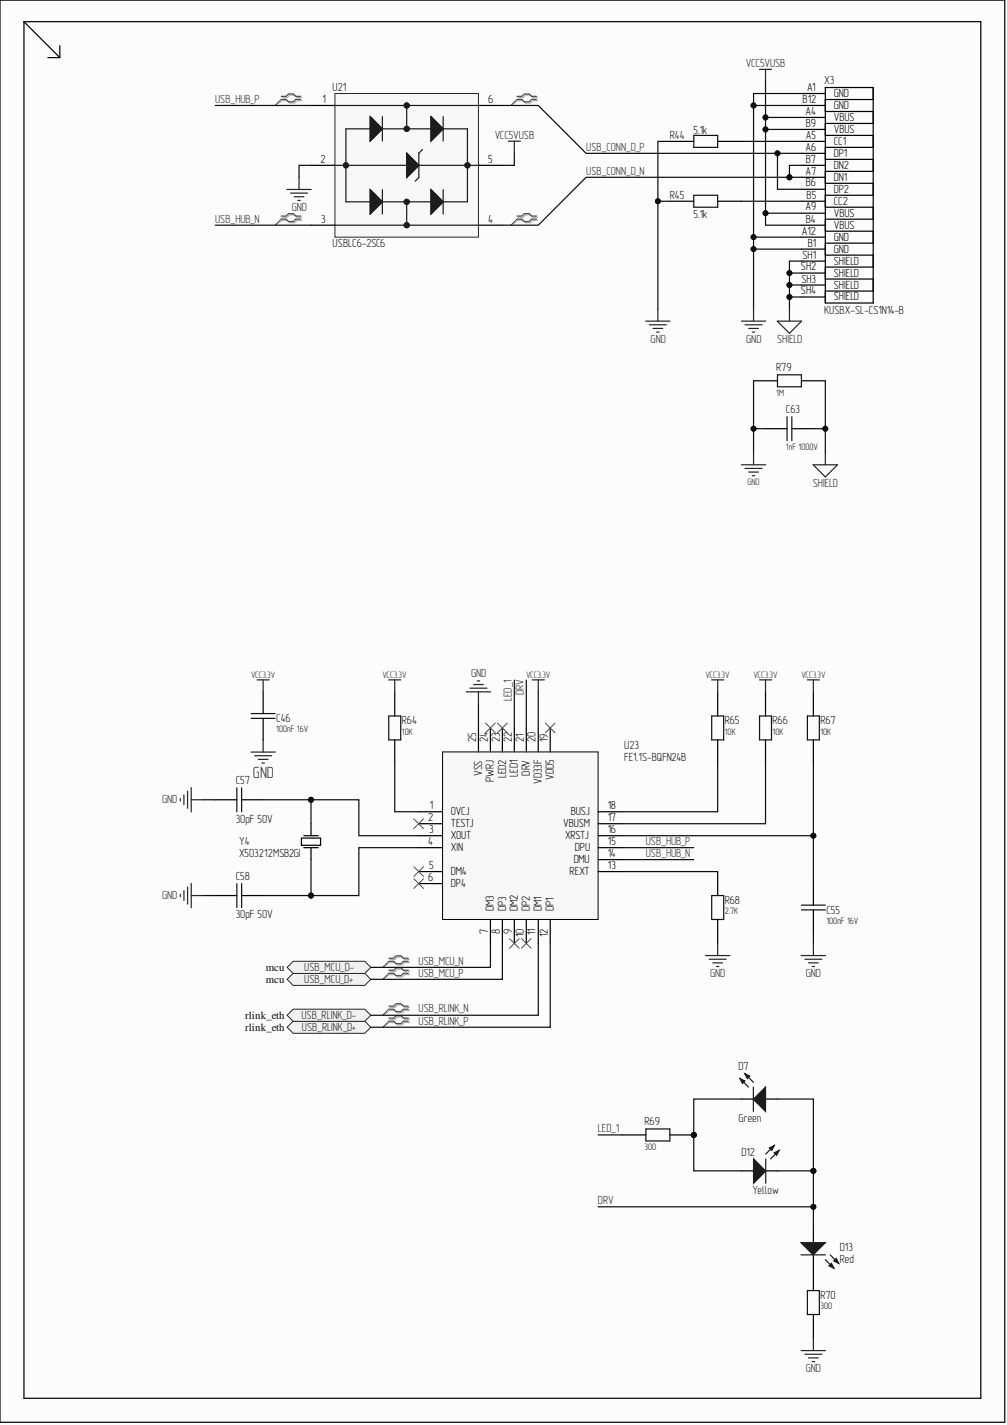
[picture p63: page 10]
