RoboticsHardwareSolutions/BareMetal-PLCs-Vault/docs/baremetal-plc-m/doc/pcb/draftsman.pdf

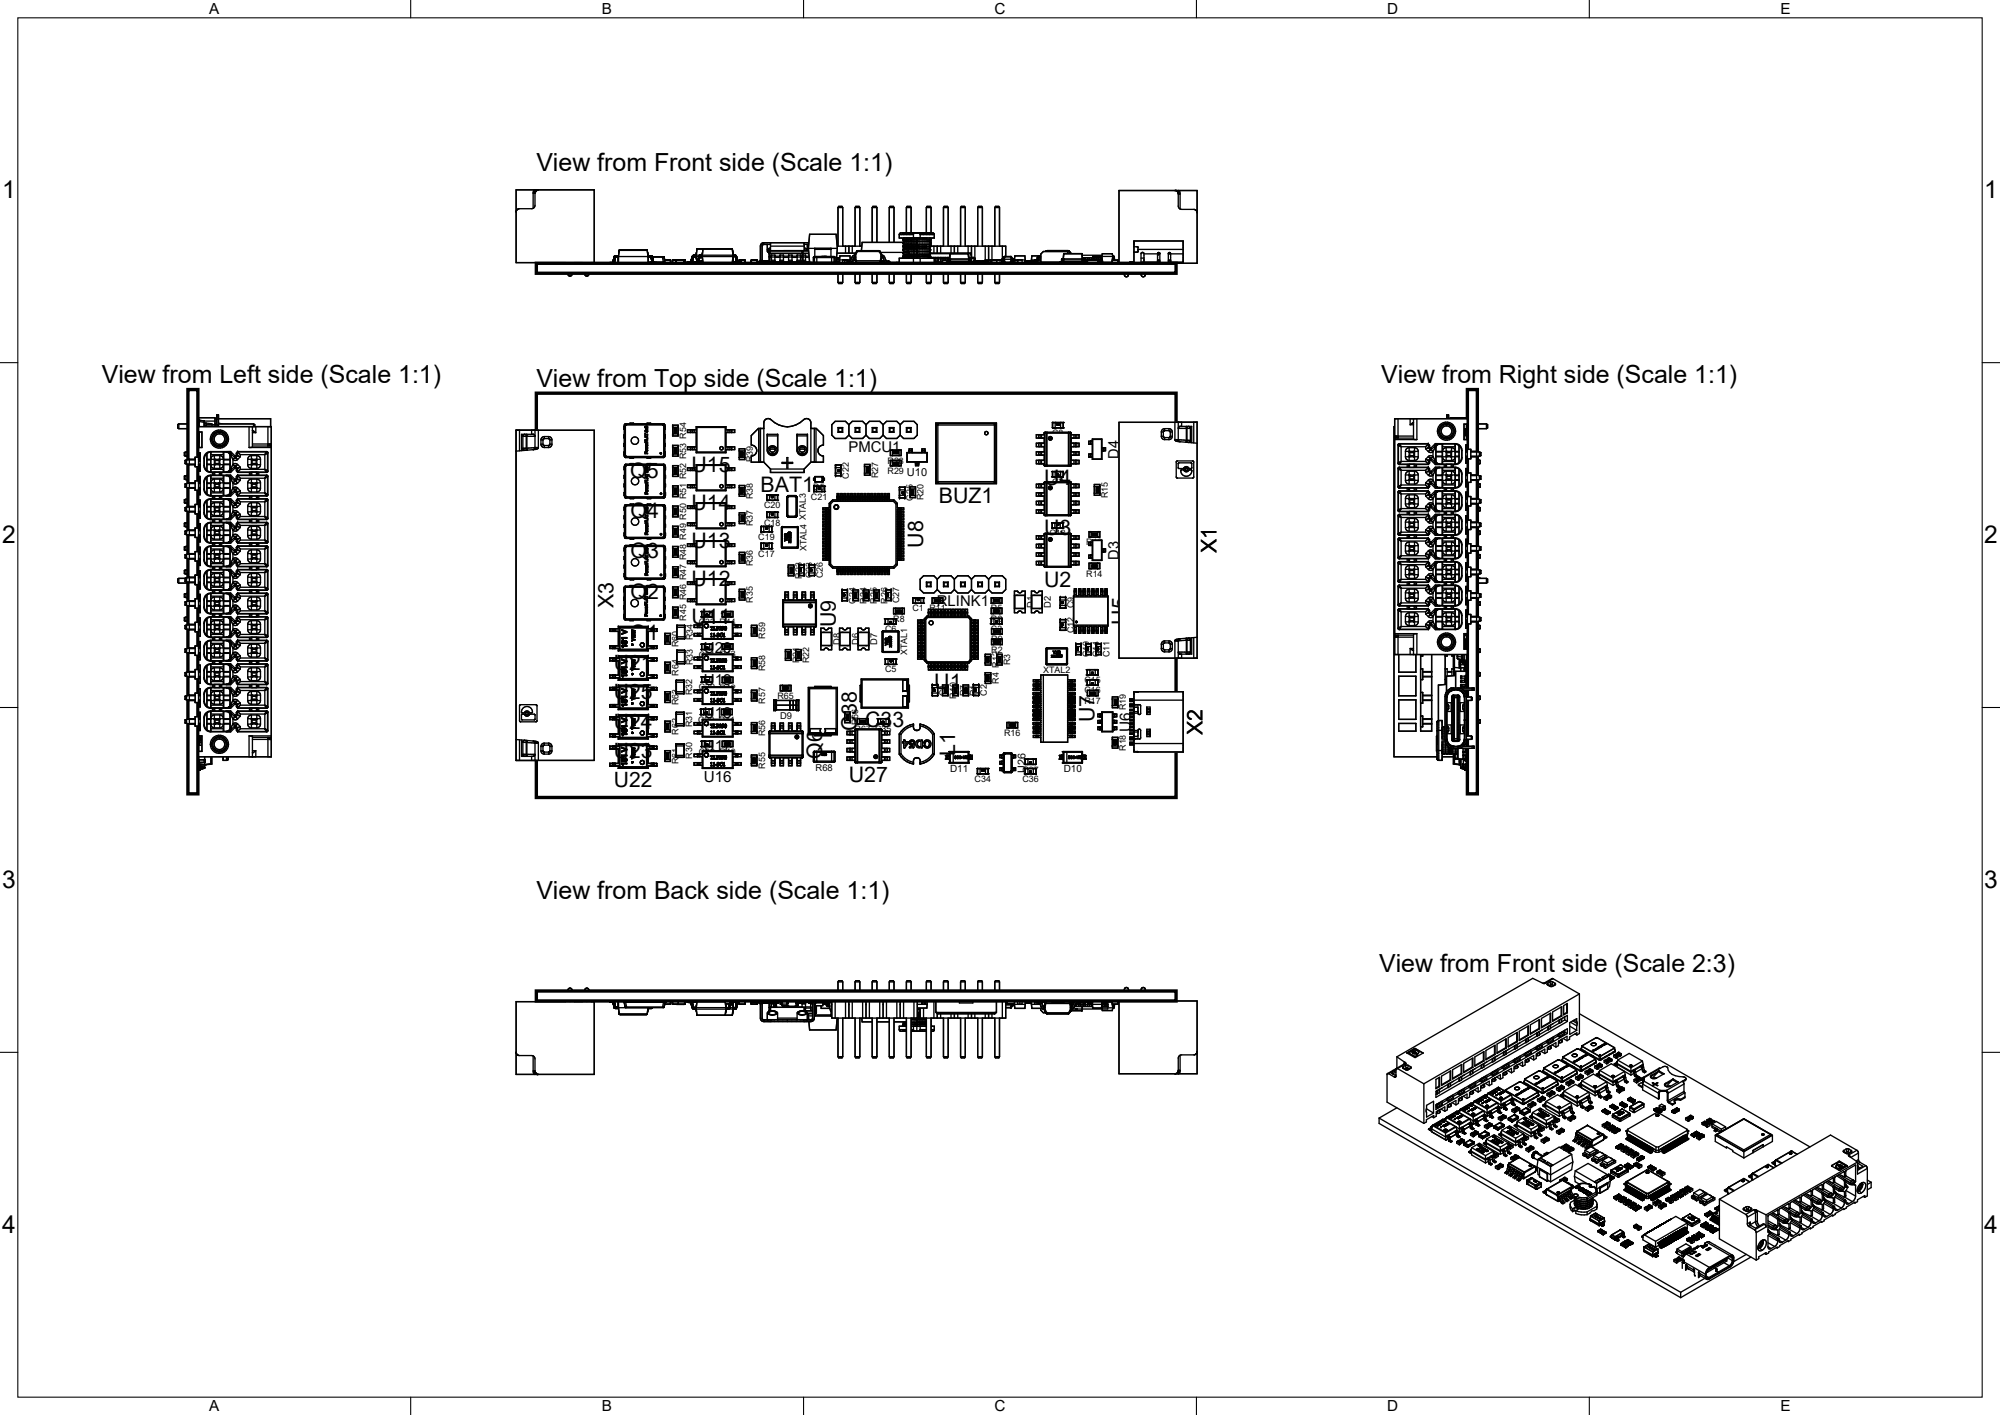
[picture p64: page 1]

View from Front side (Scale 1:1)

View from Top side (Scale 1:1)

View from Back side (Scale 1:1)

View from Front side (Scale 2:3)
