RoboticsHardwareSolutions/BareMetal-PLCs-Vault/(list of files, drawings)

Other design files:
docs/baremetal-plc-m/hardware/bmplc.prjpcb
docs/baremetal-plc-m/hardware/connections.schdoc
docs/baremetal-plc-m/hardware/dcdc.schdoc
docs/baremetal-plc-m/hardware/interfaces.schdoc
docs/baremetal-plc-m/hardware/mcu.schdoc
docs/baremetal-plc-m/hardware/pcb.pcbdoc
docs/baremetal-plc-m/hardware/rlink.schdoc
docs/baremetal-plc-m/hardware/usb.schdoc
docs/baremetal-plc-xl/hardware/bmplc.prjpcb
docs/baremetal-plc-xl/hardware/connections.schdoc
docs/baremetal-plc-xl/hardware/dcdc.schdoc
docs/baremetal-plc-xl/hardware/eeprom.schdoc
docs/baremetal-plc-xl/hardware/eth.schdoc
docs/baremetal-plc-xl/hardware/interfaces.schdoc
docs/baremetal-plc-xl/hardware/main.schdoc
docs/baremetal-plc-xl/hardware/mcu.schdoc
docs/baremetal-plc-xl/hardware/pcb.pcbdoc
docs/baremetal-plc-xl/hardware/qspi_flash.schdoc
docs/baremetal-plc-xl/hardware/rlink_eth.schdoc
docs/baremetal-plc-xl/hardware/usb.schdoc
